sinanuyan/pi_clock/photo_2024-10-13_14-28-23.jpg

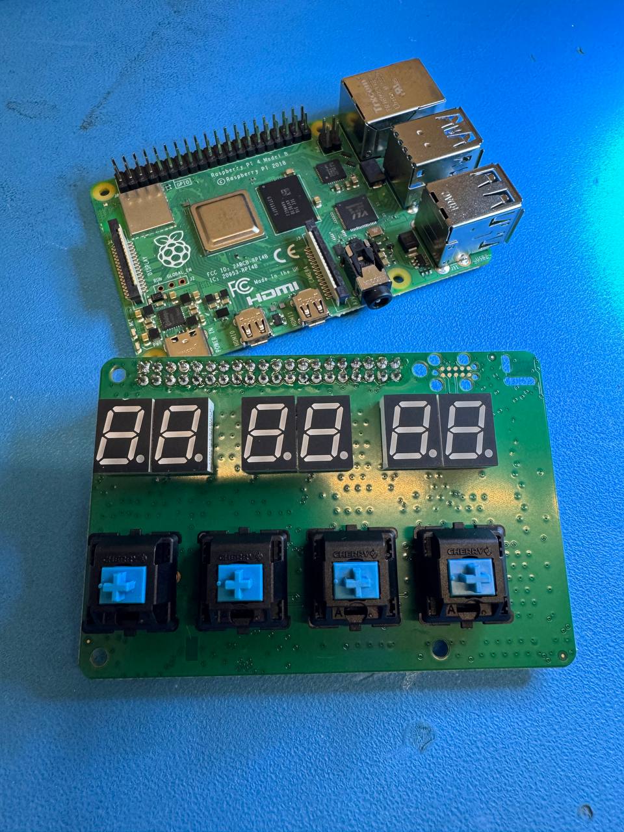
photo_2024-10-13_14-28-23.jpg
