sinanuyan/pi_clock/images/pcb/pcb_7.jpg

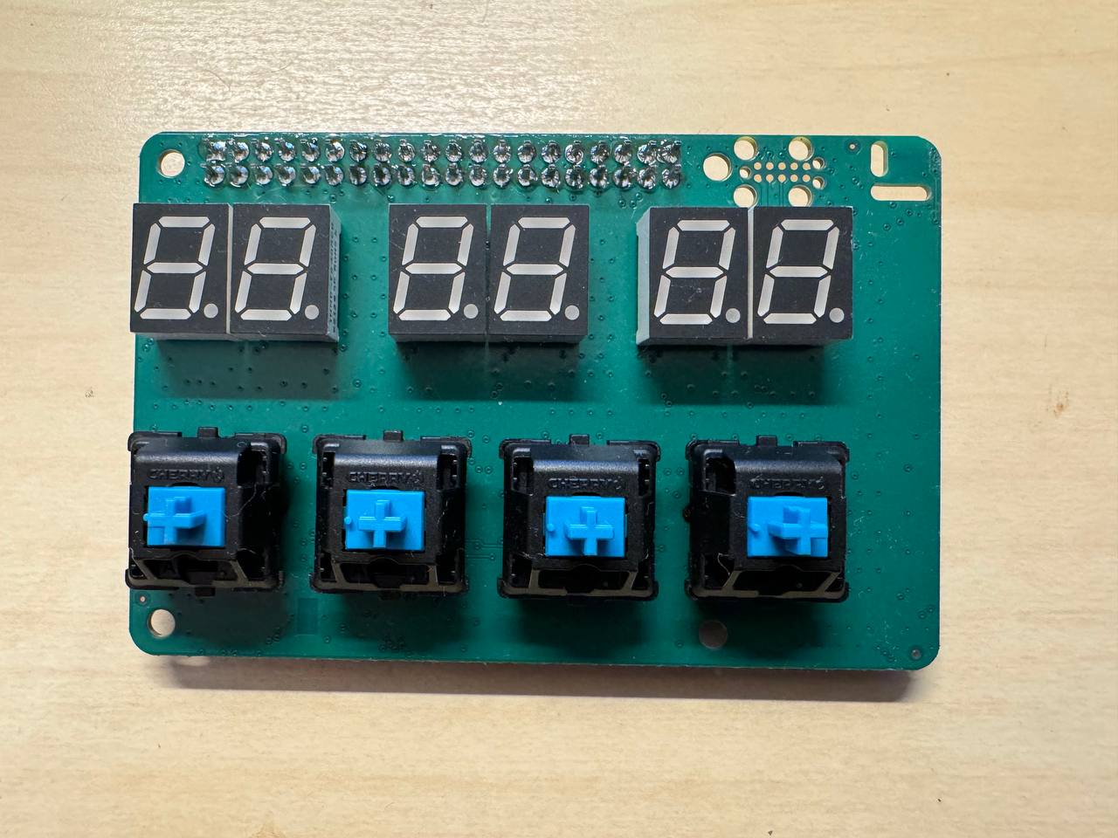
images/pcb/pcb_7.jpg
