sinanuyan/pi_clock/hardware/40_asm/README.md

This folder is for the multiboard project. Delete the multiboard project in case there is no assembly needed (e.g. wireless modules).
