sinanuyan/pi_clock/docs/back.png

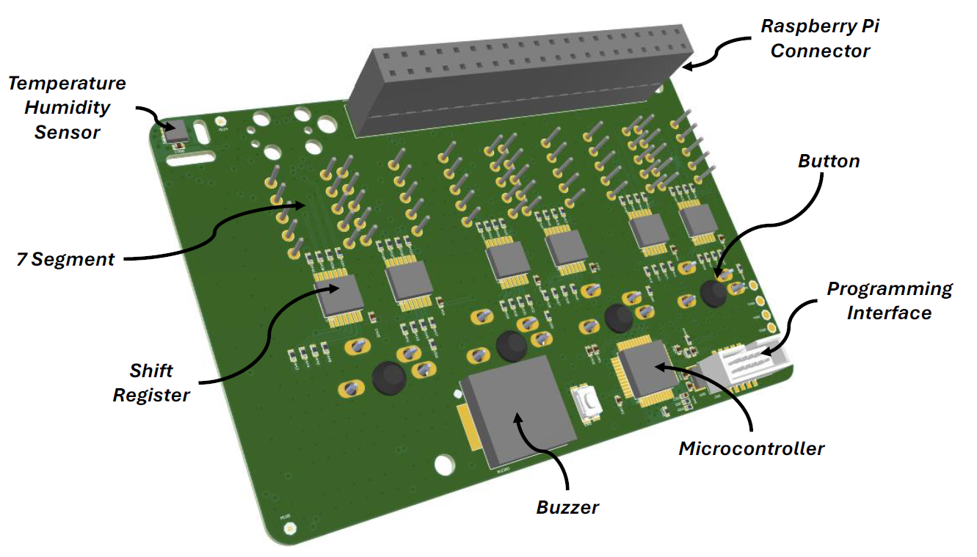
docs/back.png
