sinanuyan/pi_clock/docs/front.png

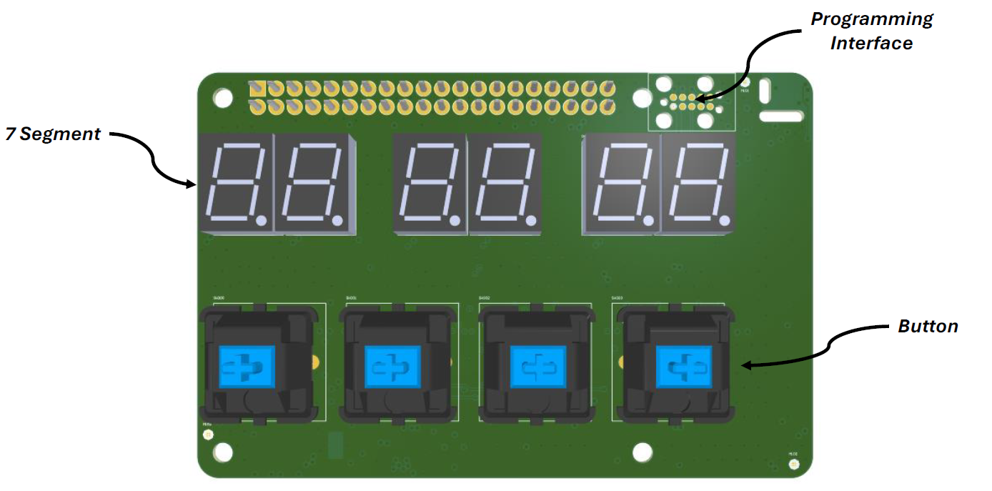
docs/front.png
