sinanuyan/pi_clock/hardware/50_doc/sch_overview.png

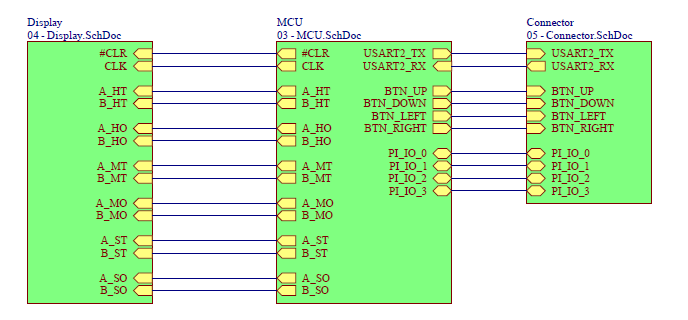
hardware/50_doc/sch_overview.png
