sinanuyan/pi_clock/images/3d_cad/pi_clock_2.png

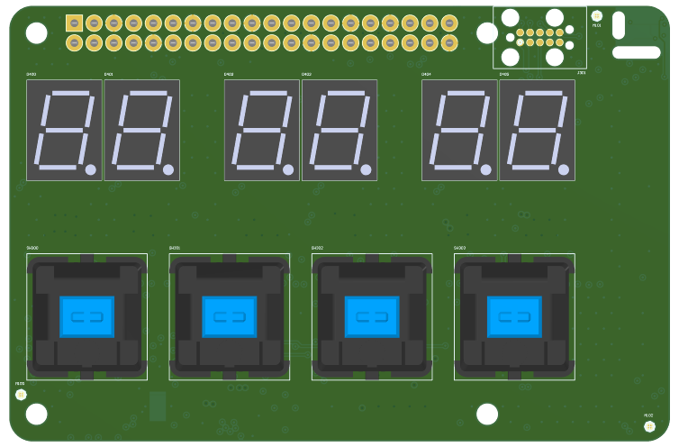
images/3d_cad/pi_clock_2.png
