sinanuyan/pi_clock/images/3d_cad/pi_clock_9.png

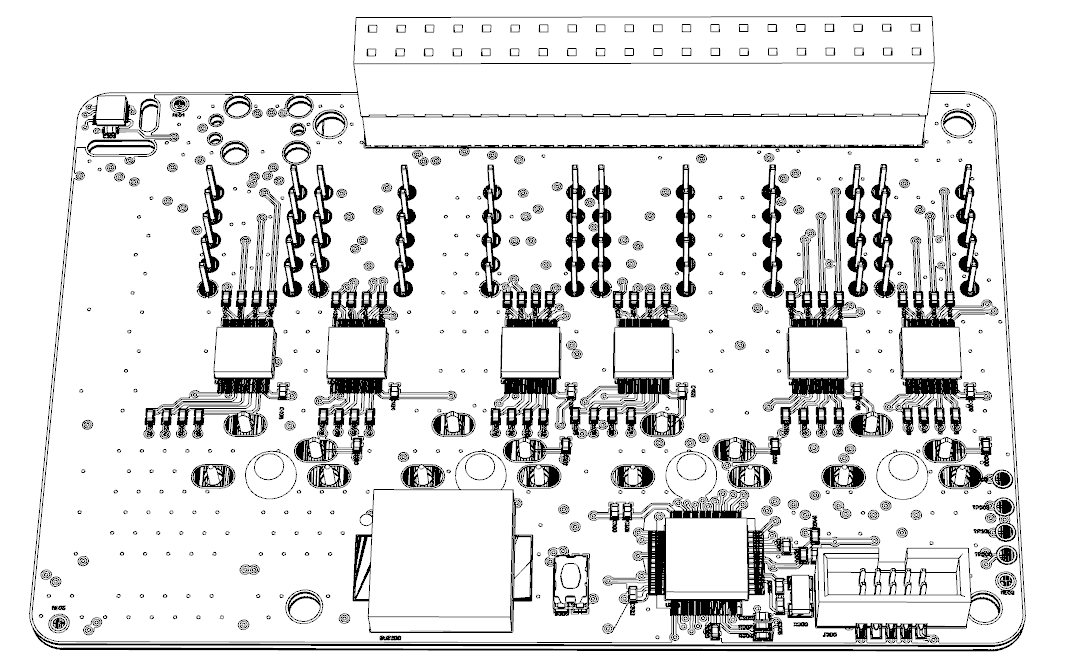
images/3d_cad/pi_clock_9.png
