sinanuyan/pi_clock/images/blockdiagram/system_overview.drawio.png

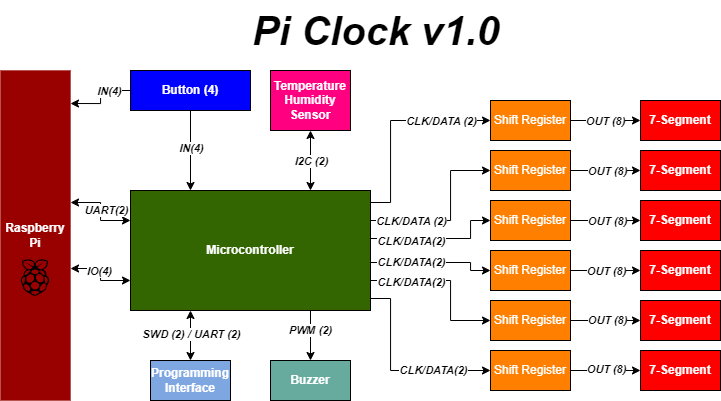
images/blockdiagram/system_overview.drawio.png
