sinanuyan/pi_clock/images/key_caps.jpg

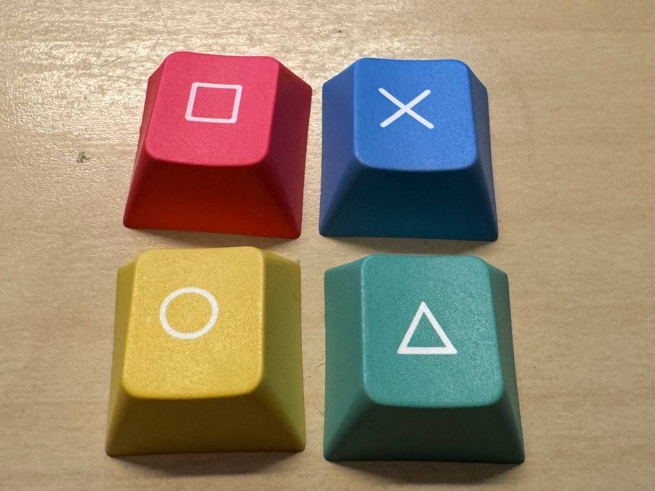
images/key_caps.jpg
