sinanuyan/pi_clock/images/pcb/pcb_1.jpg

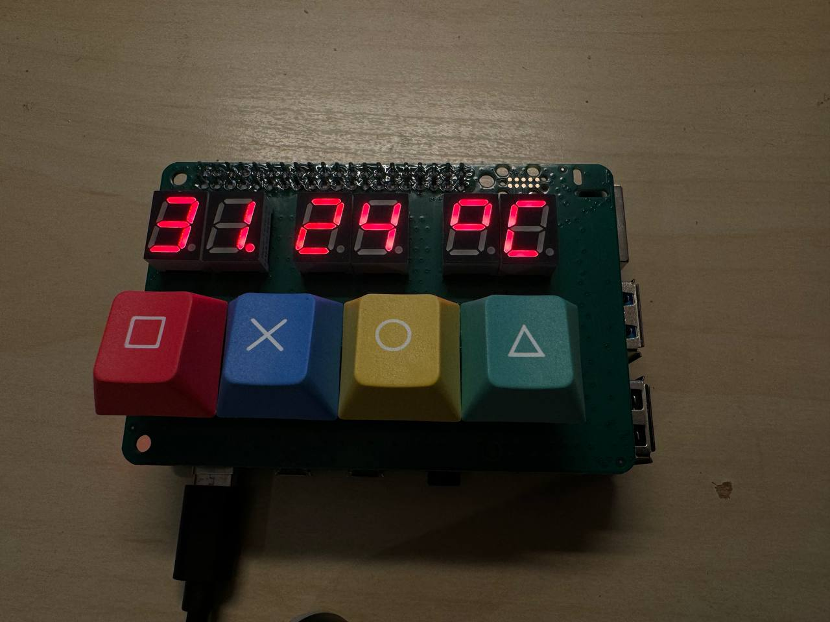
images/pcb/pcb_1.jpg
