sinanuyan/pi_clock/images/pcb/pcb_2.jpg

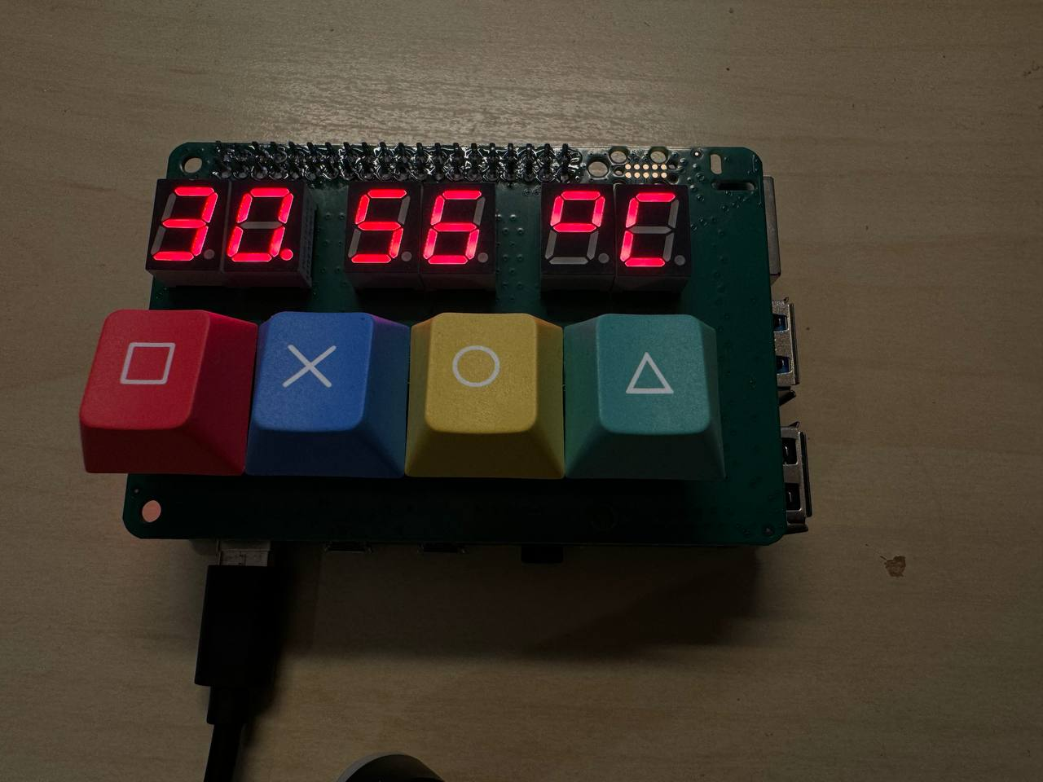
images/pcb/pcb_2.jpg
