sinanuyan/pi_clock/images/pcb/pcb_3.jpg

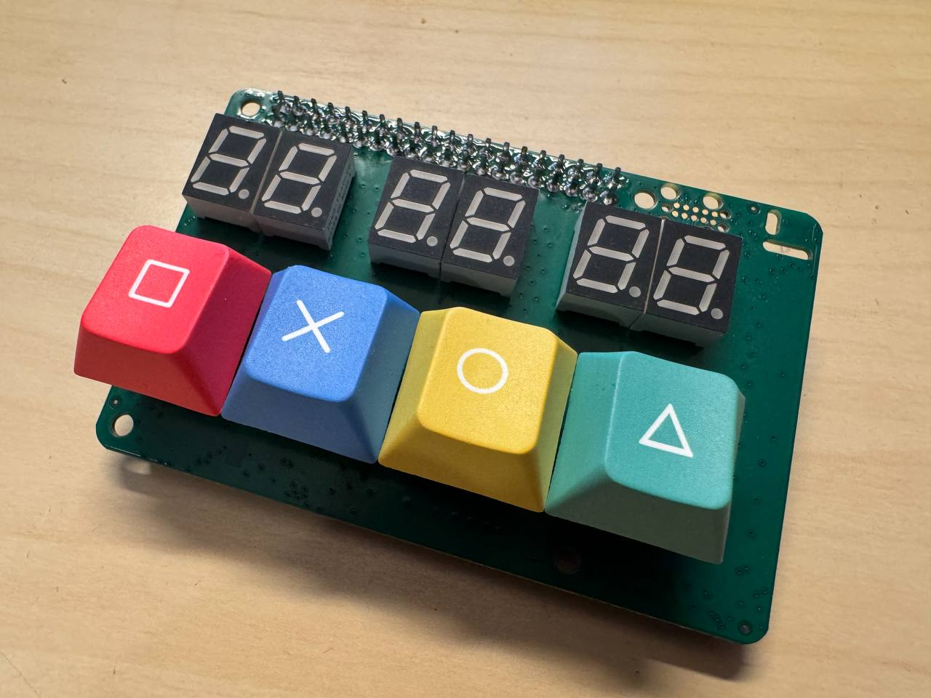
images/pcb/pcb_3.jpg
