sinanuyan/pi_clock/images/pcb/pcb_4.jpg

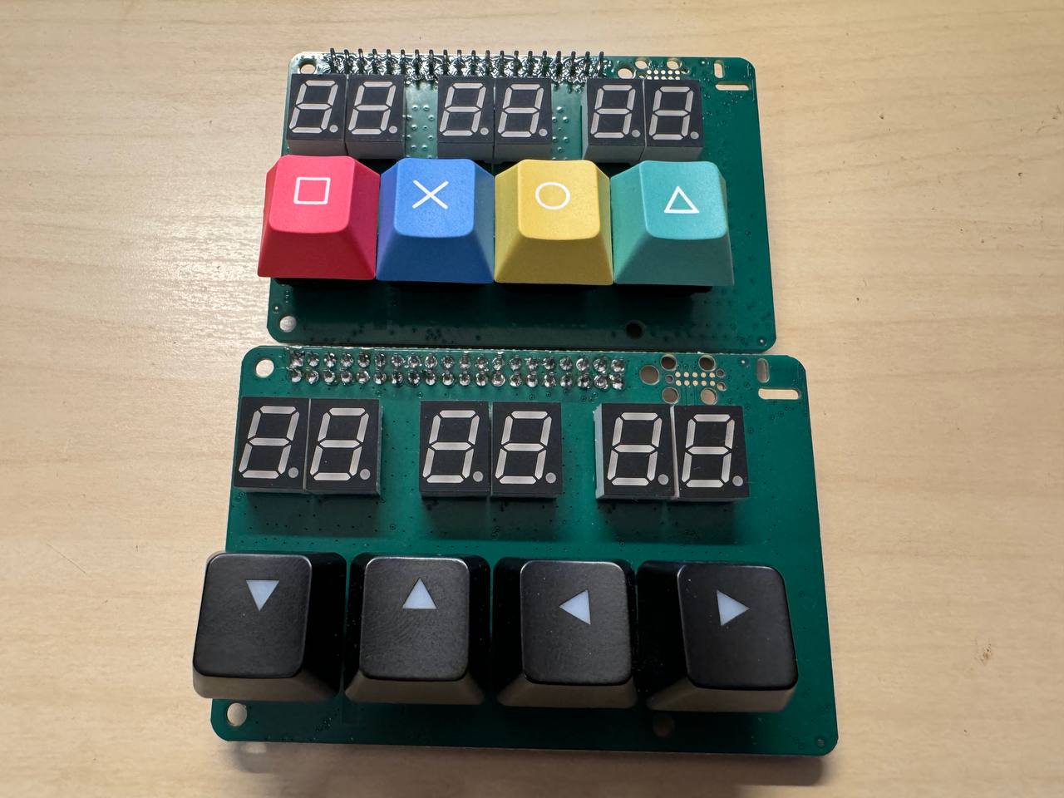
images/pcb/pcb_4.jpg
