sinanuyan/pi_clock/images/pcb/pcb_5.jpg

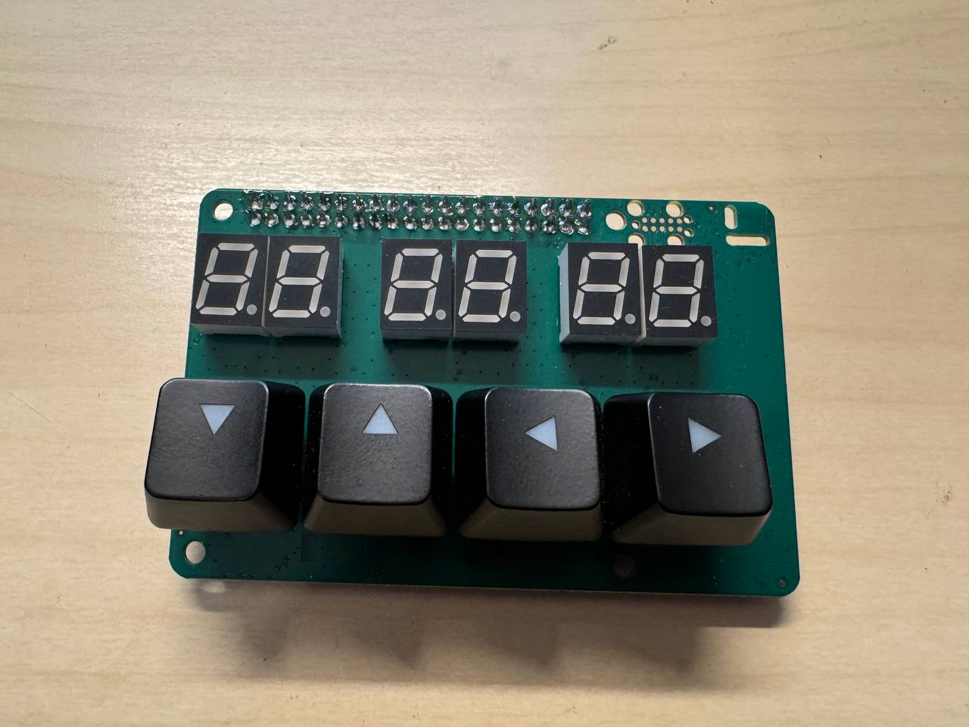
images/pcb/pcb_5.jpg
