sinanuyan/pi_clock/images/pcb/pcb_6.jpg

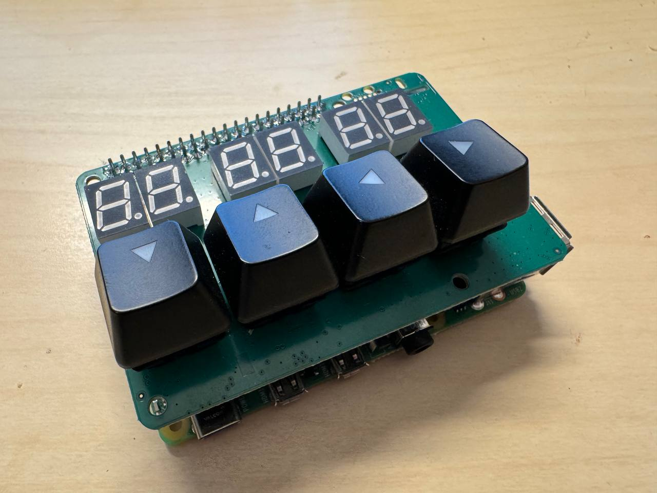
images/pcb/pcb_6.jpg
