sinanuyan/pi_clock/photo_2024-10-13_14-27-37 (2).jpg

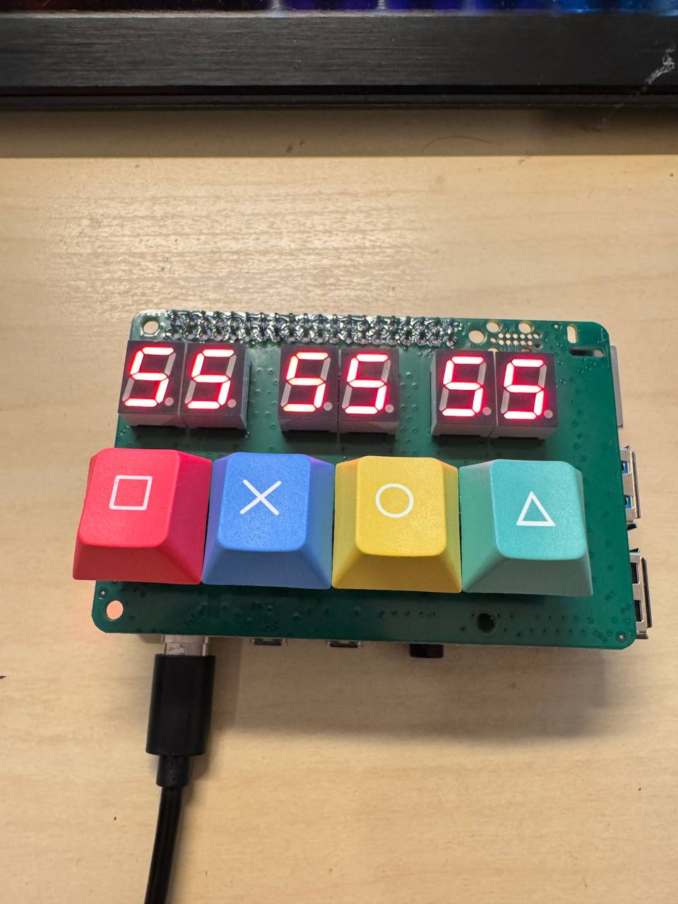
photo_2024-10-13_14-27-37 (2).jpg
