sinanuyan/pi_clock/hardware/60_projectoutput/pi-clock/pi_clock_2_B_1_SCH_BOM_PP_Data/ComponentState/pi_clock_2_B_1_ComponentState.html

Date: |  | 08.12.2024
Time: |  | 22:37:54
Elapsed Time: |  | 00:00:01
Document | Component | Result check
pi_clock.PcbDoc | D400 | Component state "New" is restricted
pi_clock.PcbDoc | D401 | Component state "New" is restricted
pi_clock.PcbDoc | D402 | Component state "New" is restricted
pi_clock.PcbDoc | D403 | Component state "New" is restricted
pi_clock.PcbDoc | D404 | Component state "New" is restricted
pi_clock.PcbDoc | D405 | Component state "New" is restricted
pi_clock.PcbDoc | J500 | Component state "New" is restricted
pi_clock.PcbDoc | SW300 | Component state "New" is restricted
pi_clock.PcbDoc | SW301 | Component state "New" is restricted
pi_clock.PcbDoc | SW302 | Component state "New" is restricted
pi_clock.PcbDoc | SW303 | Component state "New" is restricted
pi_clock.PcbDoc | U300 | Component state "New" is restricted
pi_clock.PcbDoc | U400 | Component state "New" is restricted
pi_clock.PcbDoc | U401 | Component state "New" is restricted
pi_clock.PcbDoc | U402 | Component state "New" is restricted
pi_clock.PcbDoc | U403 | Component state "New" is restricted
pi_clock.PcbDoc | U404 | Component state "New" is restricted
pi_clock.PcbDoc | U405 | Component state "New" is restricted
03 - MCU.SchDoc | SW300 | Component state "New" is restricted
03 - MCU.SchDoc | SW301 | Component state "New" is restricted
03 - MCU.SchDoc | SW302 | Component state "New" is restricted
03 - MCU.SchDoc | SW303 | Component state "New" is restricted
03 - MCU.SchDoc | U300 | Component state "New" is restricted
04 - Display.SchDoc | D400 | Component state "New" is restricted
04 - Display.SchDoc | D401 | Component state "New" is restricted
04 - Display.SchDoc | D402 | Component state "New" is restricted
04 - Display.SchDoc | D403 | Component state "New" is restricted
04 - Display.SchDoc | D404 | Component state "New" is restricted
04 - Display.SchDoc | D405 | Component state "New" is restricted
04 - Display.SchDoc | U400 | Component state "New" is restricted
04 - Display.SchDoc | U401 | Component state "New" is restricted
04 - Display.SchDoc | U402 | Component state "New" is restricted
04 - Display.SchDoc | U403 | Component state "New" is restricted
04 - Display.SchDoc | U404 | Component state "New" is restricted
04 - Display.SchDoc | U405 | Component state "New" is restricted
05 - Connector.SchDoc | J500 | Component state "New" is restricted
