sinanuyan/pi_clock/hardware/60_projectoutput/pi-clock/pi_clock_2_B_1_SCH_BOM_PP_Data/BOM/pi_clock_2_B_1_BOM.xlsx

Designator | Quantity | Comment | Description | Footprint | Properties | Supplier 1 | Supplier Part Number 1 | Manufacturer | Manufacturer Part Number | Replaceable (YES/NO/with)
BUZ300 | 1 | AST1240MLTRQ | Buzzers Transducer, Externally Driven Piezo 3V 5mA 4kHz 75dB @ 3V, 10cm Surface Mount Solder Pads | AST1240MLTRQ |  | DigiKey | 458-1094-1-ND | Mallory Sonalert Products Inc. | AST1240MLTRQ
C300 | 1 | CL05A106MP8NUB8 | 10µF ±20% 10V Ceramic Capacitor X5R 0402 (1005 Metric) | CAPC0402(1005)60_L |  | Digi-Key | 1276-6830-1-ND | Samsung Electro-Mechanics | CL05A106MP8NUB8
C301, C302, C303, C304, C307, C308, C400, C401, C402, C403, C404, C405 | 12 | GRM155R62A104KE14D | 0.1µF ±10% 100V Ceramic Capacitor X5R 0402 (1005 Metric) | CAPC0402(1005)60_L |  | Digi-Key | 490-10458-1-ND | Murata Electronics | GRM155R62A104KE14D
C305, C306 | 2 | CC0402BRNPO9BN9R0 | 9pF ±0.1pF 50V Ceramic Capacitor C0G, NP0 0402 (1005 Metric) | CAPC0402(1005)60_L |  | Digi-Key | 311-1629-1-ND | Yageo | CC0402BRNPO9BN9R0
D400, D401, D402, D403, D404, D405 | 6 | INND-TS40RCB | Display Modules - LED Character and Numeric Red 7-Segment 1 Character Common Cathode 2V 20mA 0.508" H x 0.379" W x 0.250" D (12.90mm x 9.63mm x 6.36mm) 10-DIP (0.300", 7.62mm) | INND-TS40RCB-Footprint-1 |  | Digi-Key | 1830-1155-ND | Inolux | INND-TS40RCB
J300 | 1 | 3220-10-0300-00 | Connector Header Surface Mount 10 position 0.050" (1.27mm) | 3220-10-0300-00-Footprint-1 |  | Digi-Key | 1175-1629-ND | CNC Tech | 3220-10-0300-00
J500 | 1 | ESW-120-23-T-D | 40 Position Elevated Socket Connector 0.100" (2.54mm) Through Hole Tin | ESW-120-23-T-D-Footprint-1 |  | Digi-Key | 2031-ESW-120-23-T-D-ND | Samtec Inc. | ESW-120-23-T-D
Q400, Q401, Q402, Q403, Q404, Q405 | 6 | BSS138L | MOSFET N-CH 50V 200MA SOT-23 | SOT23-3 |  | Digikey | BSS138LCT-ND | ON Semiconductor | BSS138L
R300, R301, R302, R303, R304, R305, R306, R307, R400, R449, R450, R451, R452, R453, R454 | 15 | RMCF0402FT4K70 | 4.7 kOhms ±1% 0.063W, 1/16W Chip Resistor 0402 (1005 Metric) Automotive AEC-Q200 Thick Film | RESC0402(1005)_L |  | Digi-Key | RMCF0402FT4K70CT-ND | Stackpole Electronics Inc | RMCF0402FT4K70
R401, R402, R403, R404, R405, R406, R407, R408, R409, R410, R411, R412, R413, R414, R415, R416, R417, R418, R419, R420, R421, R422, R423, R424, R425, R426, R427, R428, R429, R430, R431, R432, R433, R434, R435, R436, R437, R438, R439, R440, R441, R442, R443, R444, R445, R446, R447, R448 | 48 | RMCF0402FT470R | 470 Ohms ±1% 0.063W, 1/16W Chip Resistor 0402 (1005 Metric) Automotive AEC-Q200 Thick Film | RESC0402(1005)_L |  | Digi-Key | 738-RMCF0402FT470RCT-ND | Stackpole Electronics Inc | RMCF0402FT470R
S300 | 1 | KMR211GLFS | SWITCH TACTILE SPST-NO 0.05A 32V | KMR211GLFS |  | Digi-Key | 401-1426-1-ND | C&K Components | KMR211GLFS
SW300, SW301, SW302, SW303 | 4 | MX1A-E1NW | Pushbutton Switch SPST-NO Keyswitch Through Hole | MX1A-E1NW-Footprint-1 |  | Digi-Key | CH197-ND | Cherry Americas LLC | MX1A-E1NW
U300 | 1 | STM32L010C6T6 | RISC Microcontroller, 32-Bit, FLASH, CORTEX-M0 CPU, 32MHz | LQFP-48 (LQ) |  | Digi-Key | 497-19662-ND | STMicroelectronics | STM32L010C6T6
U301 | 1 | SHT31-DIS-B | SENSIRION SHT31-DIS-B Humidity Sensor, 2 %, 3.3 V, 0% to 100% Relative Humidity, TDFN, 8 Pins, 8 s | 8 - Pin DFN 2.5 x 2.5 mm x 0.9 mm |  | Digi-Key | 1649-1011-1-ND | Sensirion | SHT31-DIS-B
U400, U401, U402, U403, U404, U405 | 6 | SN74HCS264PWR | Shift Shift Register 1 Element 8 Bit 14-TSSOP | TSSOP-14 |  | Digi-Key | 296-SN74HCS264PWRCT-ND | Texas Instruments | SN74HCS264PWR
X300 | 1 | ABS07-32.768KHZ-6-T | 32.768kHz ±20ppm Crystal 6pF 70 kOhms 2-SMD, No Lead | ABRA-ABS07_V |  | Digi-Key | 535-11898-1-ND | Abracon LLC | ABS07-32.768KHZ-6-T
