sinanuyan/pi_clock/hardware/enclosure_top-Extrude.stl

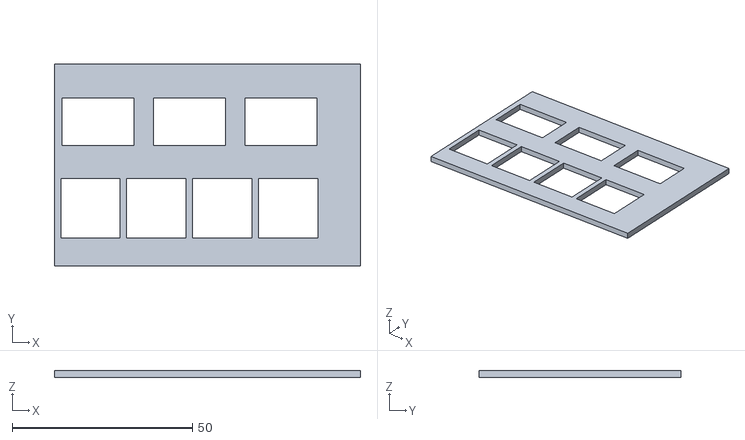
[picture p29: CAD file, 2025-01-09]
hardware/enclosure_top-Extrude.stl
85.0 x 56.0 x 2.00
