sinanuyan/pi_clock/hardware/enclosure_top.FCStd

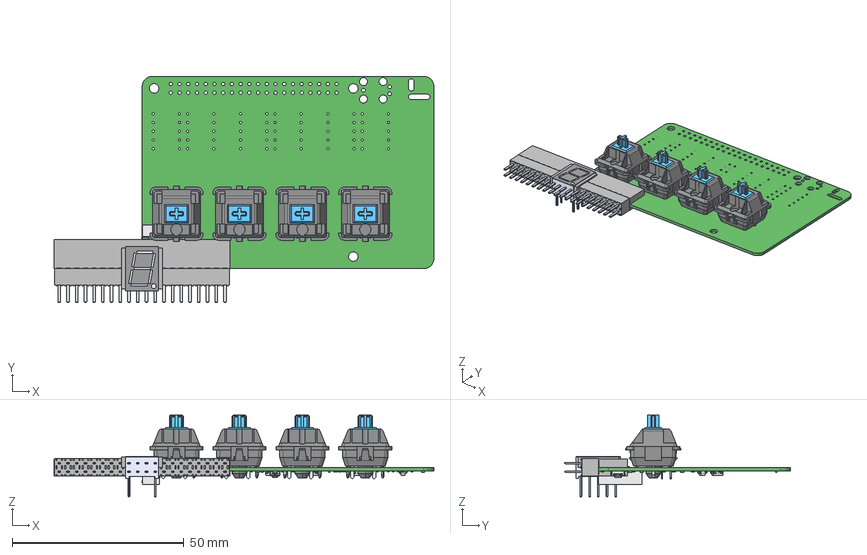
[picture p30: CAD file, 2025-01-09]
hardware/enclosure_top.FCStd
110.7 x 65.9 x 23.8 mm
R0402
R0403
R0404
R0405
R0406
R0407
R0408
R0409
R0410
R0411
R0412
R0413
R0414
R0415
R0416
R0417
R0418
R0419
R0420
R0421
R0422
R0423
R0424
R0425
User Library-SOT23-3
User Library-SOT23-004
User Library-SOT23-005
User Library-SOT23-006
User Library-SOT23-007
User Library-SOT23-008
Extruded
R0426
R0427
R0428
R0429
R0430
R0431
R0432
R0433
User Library-cap_0402
Extruded001
ESW-120-23-T-D_socket
ESW-120-23-T-D_pins
ESW-120-23-T-D2_PINS
ESW-120-23-T-D_bsocket
Extruded002
Extruded003
Extruded004
Extruded005
Extruded006
Extruded007
Extruded008
Extruded009
MX1A-E1NW
MX1A-E1NW001
MX1A-E1NW002
MX1A-E1NW003
MX1A-E1NW004
MX1A-E1NW005
MX1A-E1NW006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
