sinanuyan/pi_clock/hardware/60_projectoutput/pi-clock/pi_clock_2_B_1_PCB_Data/pi_clock_x_B_1_Technical_Data.pdf

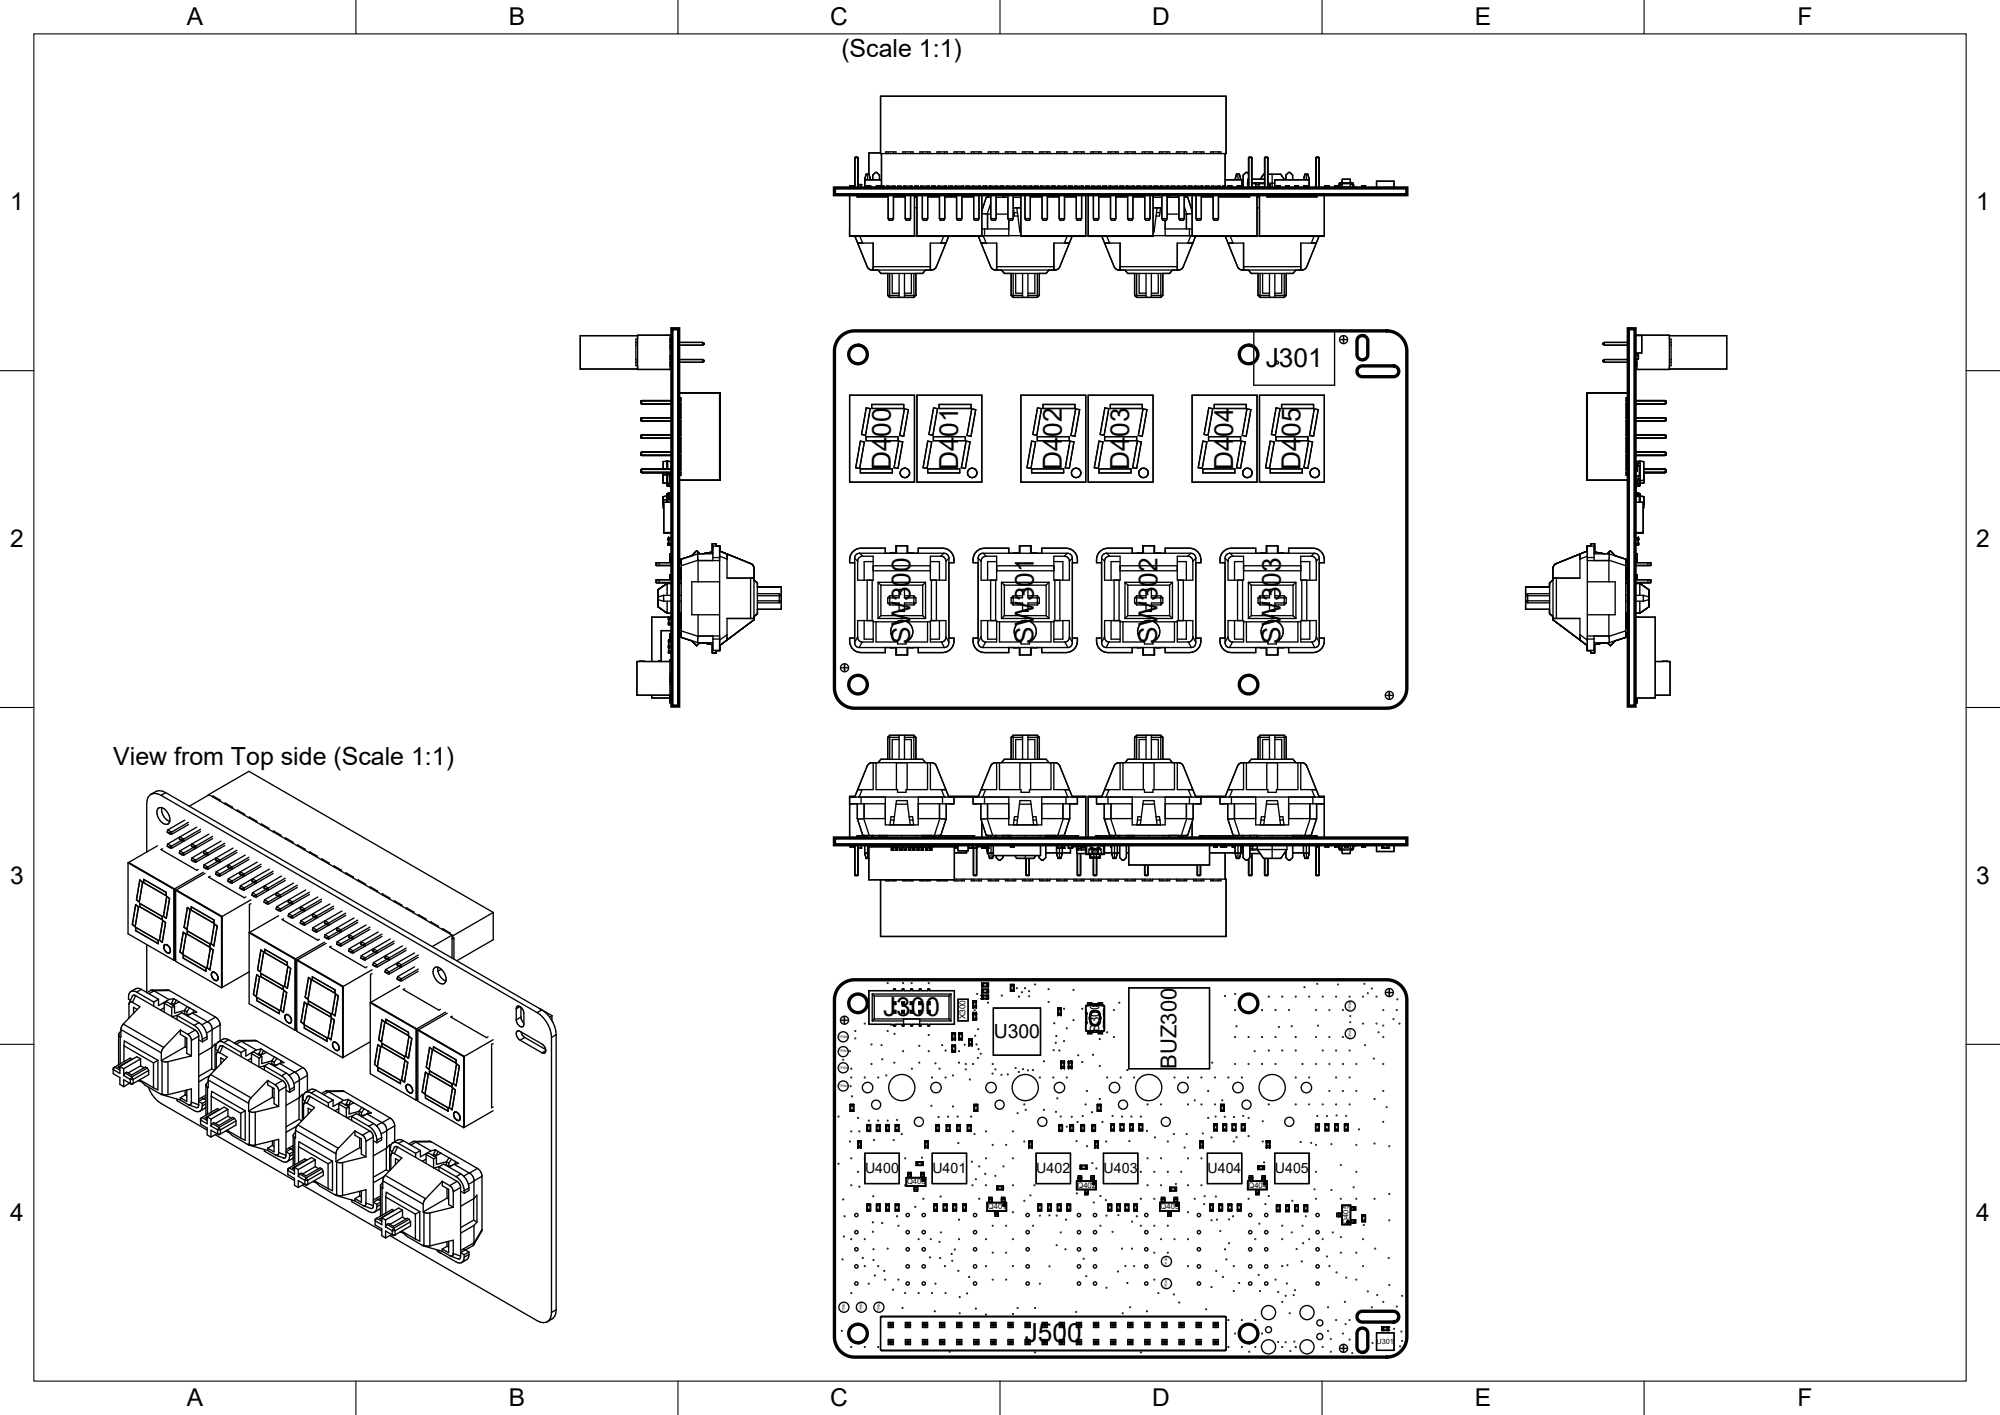
[picture p31: page 1]

View from Top side (Scale 1:1)

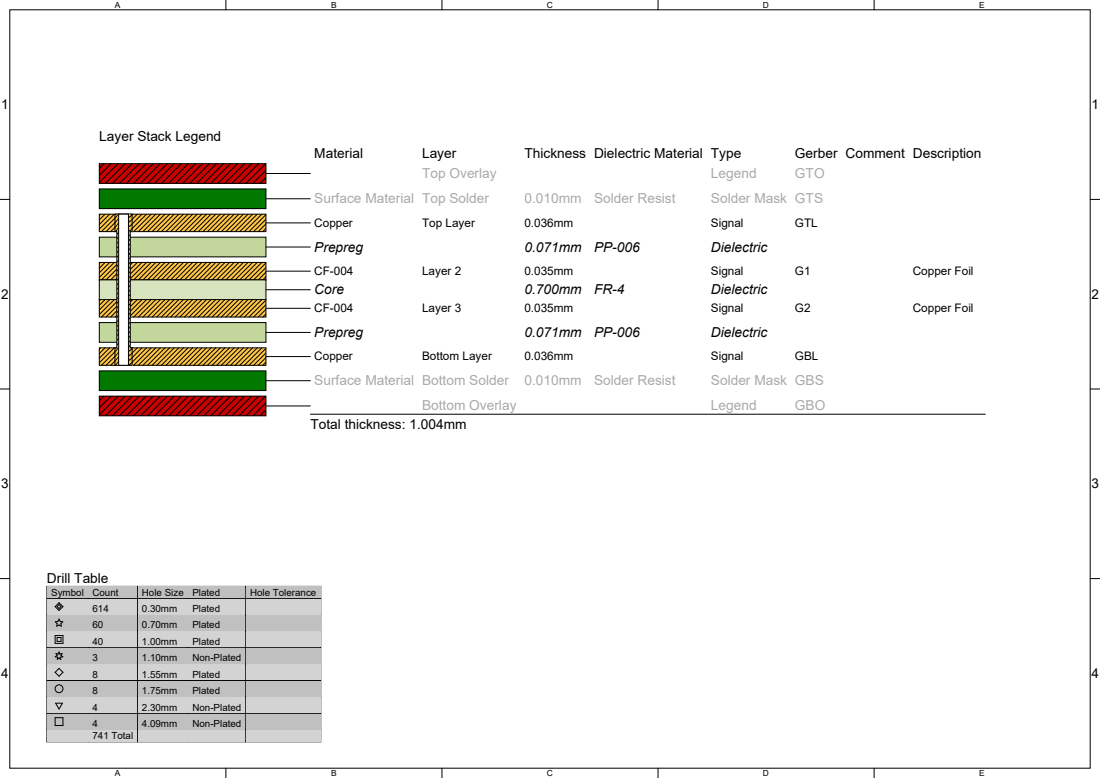
[picture p32: page 2]

Symbol | Count | Hole Size | Plated | Hole Tolerance

614 | 0.30mm | Plated
60 | 0.70mm | Plated
40 | 1.00mm | Plated
3 | 1.10mm | Non-Plated
8 | 1.55mm | Plated
8 | 1.75mm | Plated
4 | 2.30mm | Non-Plated
4 | 4.09mm | Non-Plated
741 Total

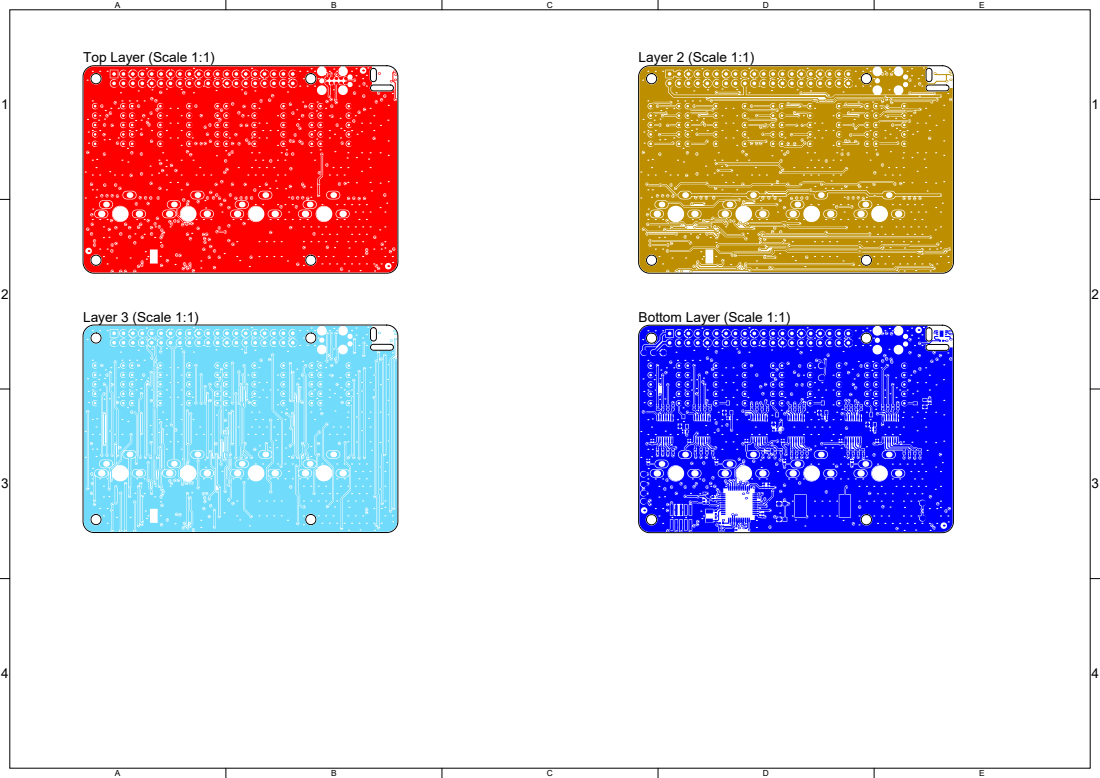
[picture p33: page 3]

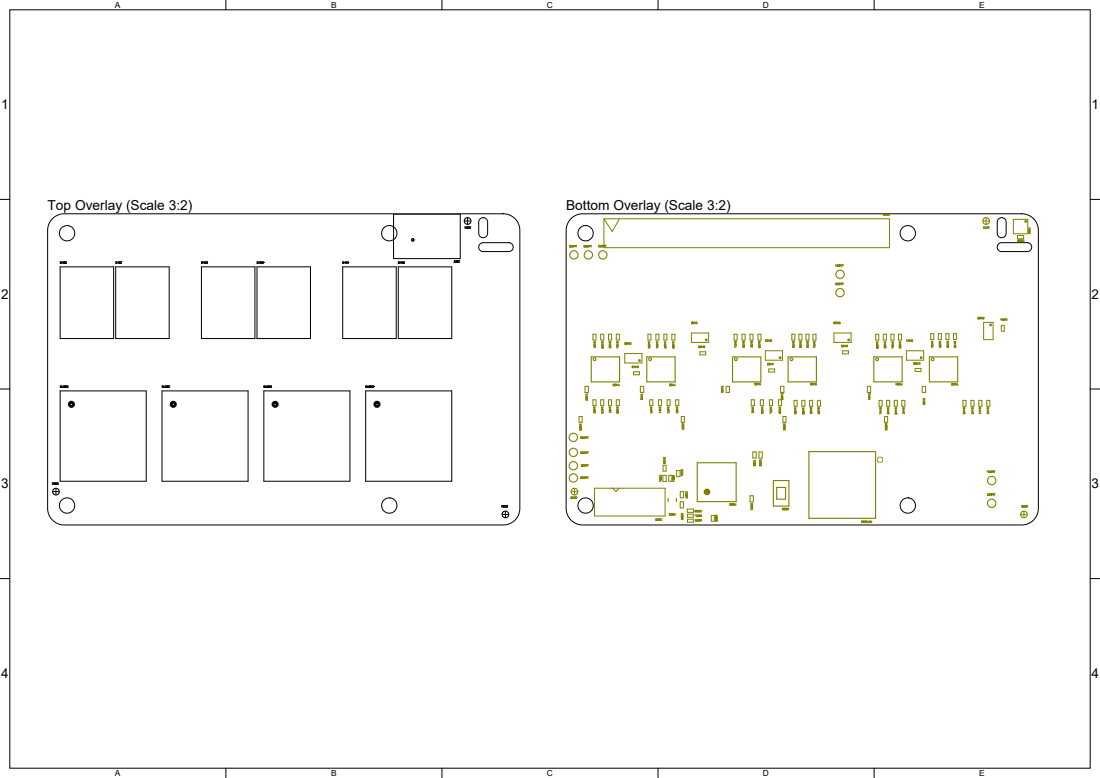
[picture p34: page 4]

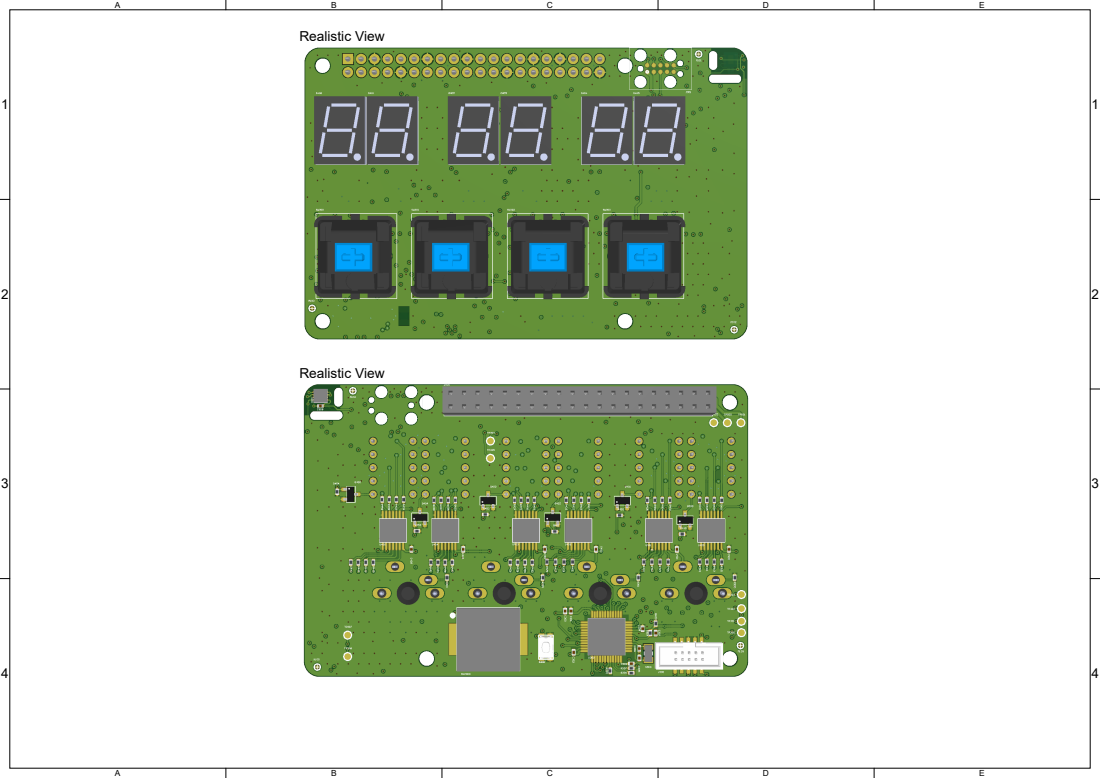
[picture p35: page 5]

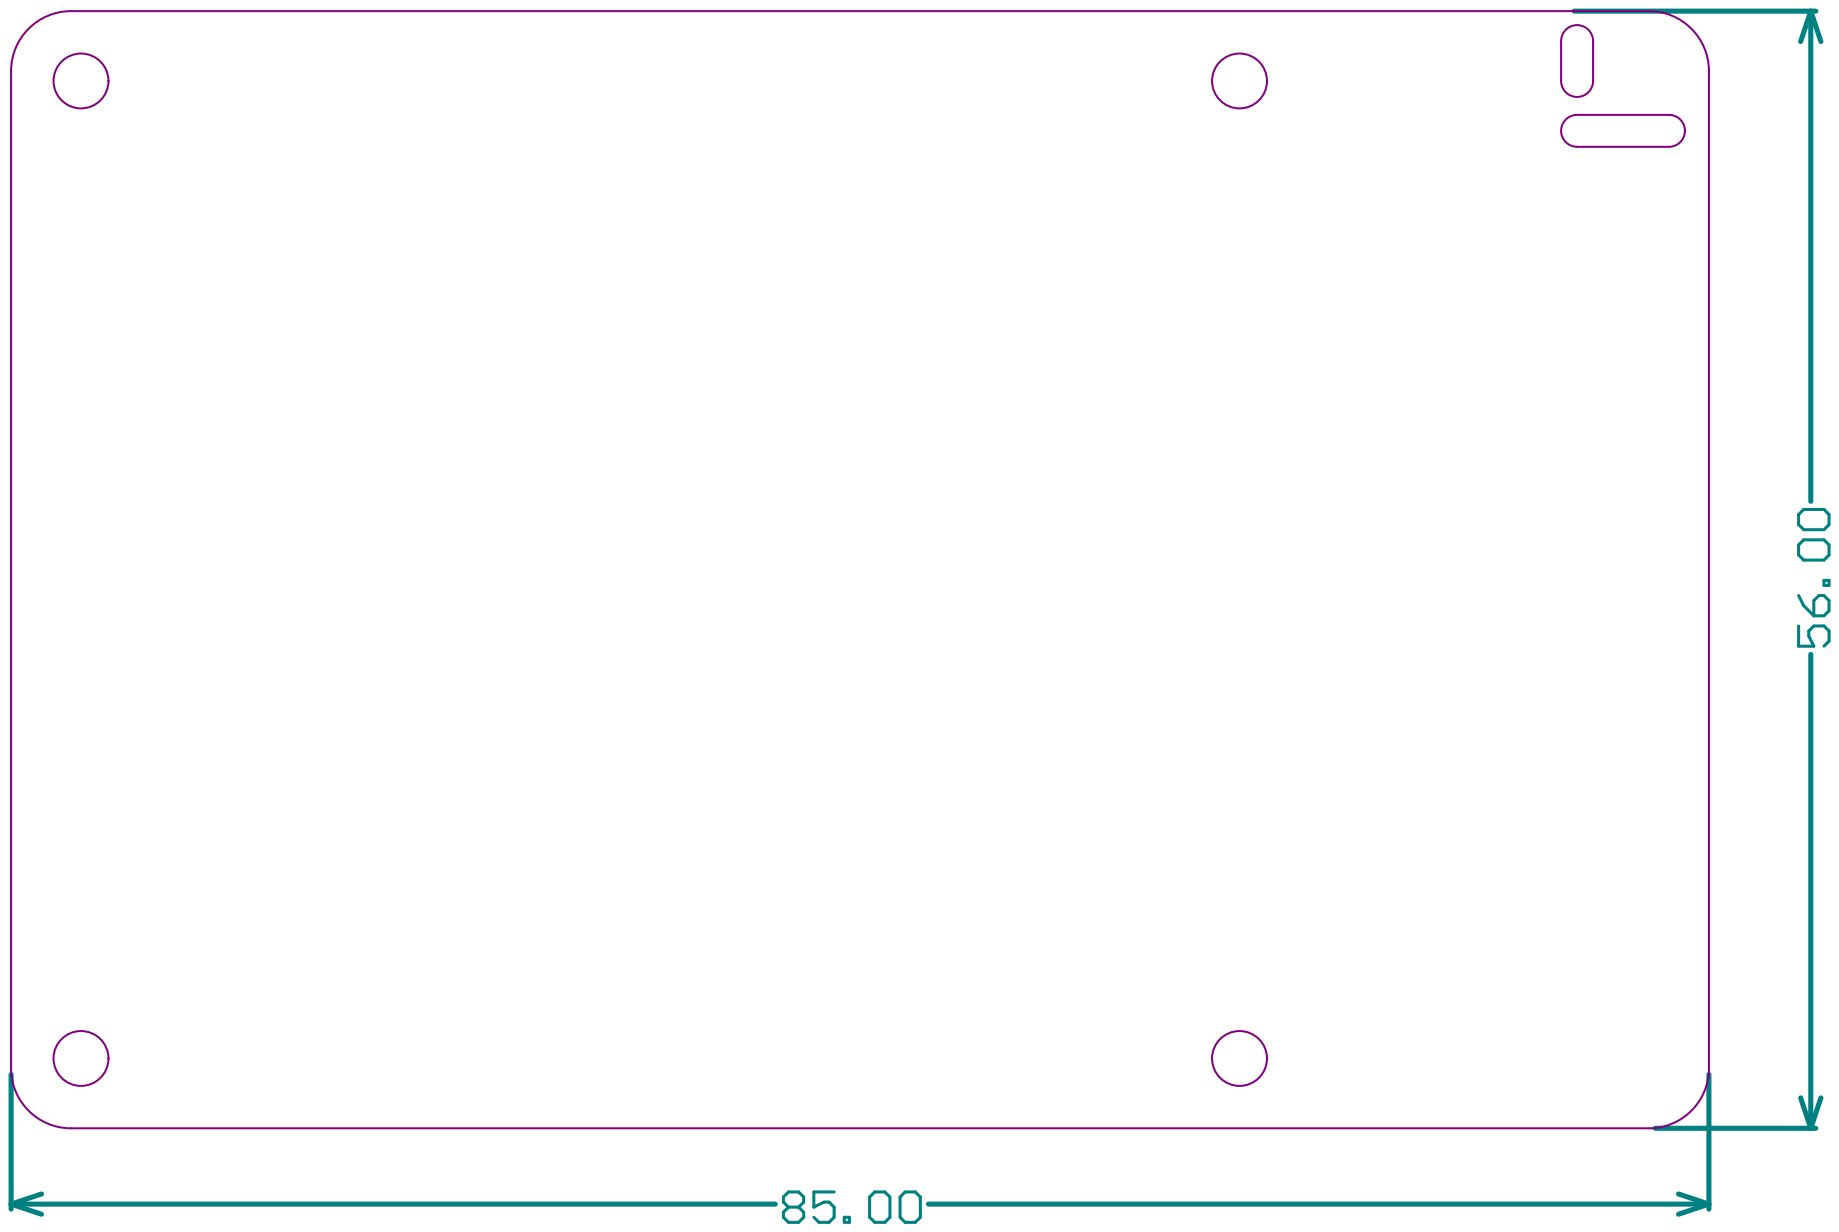
[picture p36: page 6]

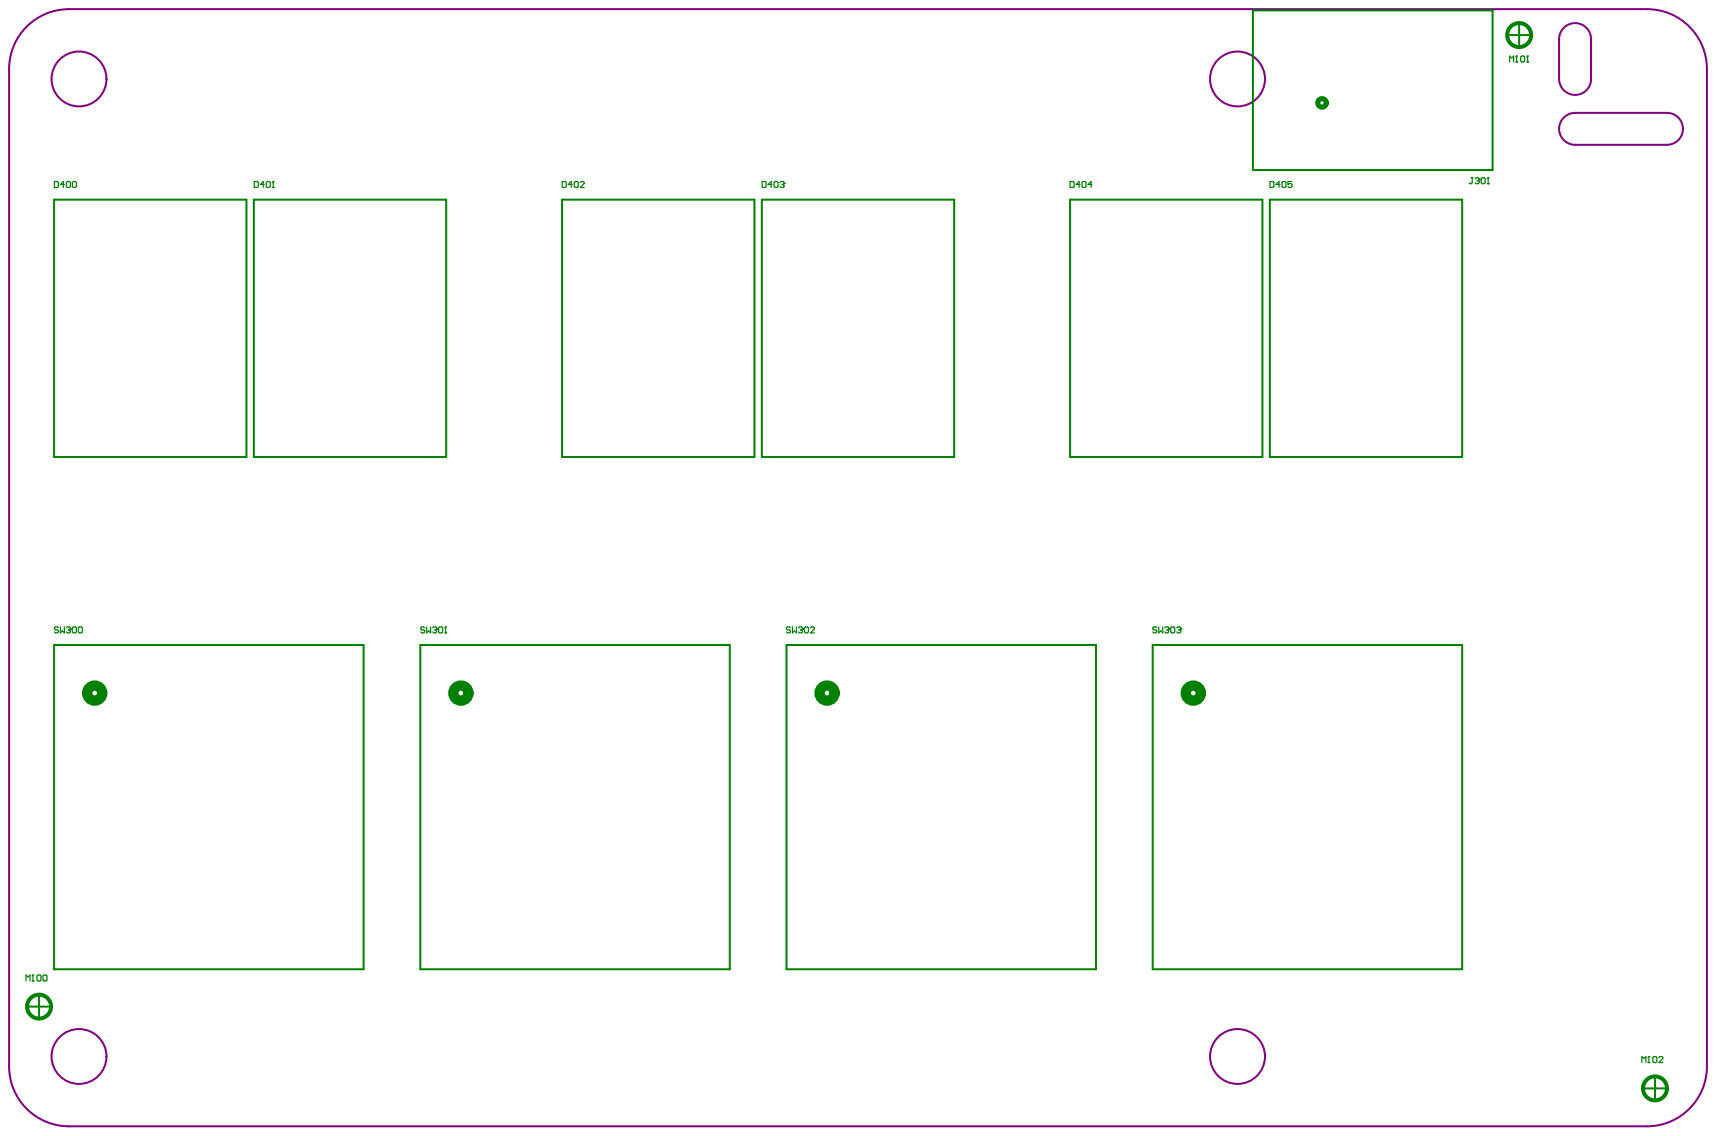
[picture p37: page 7]

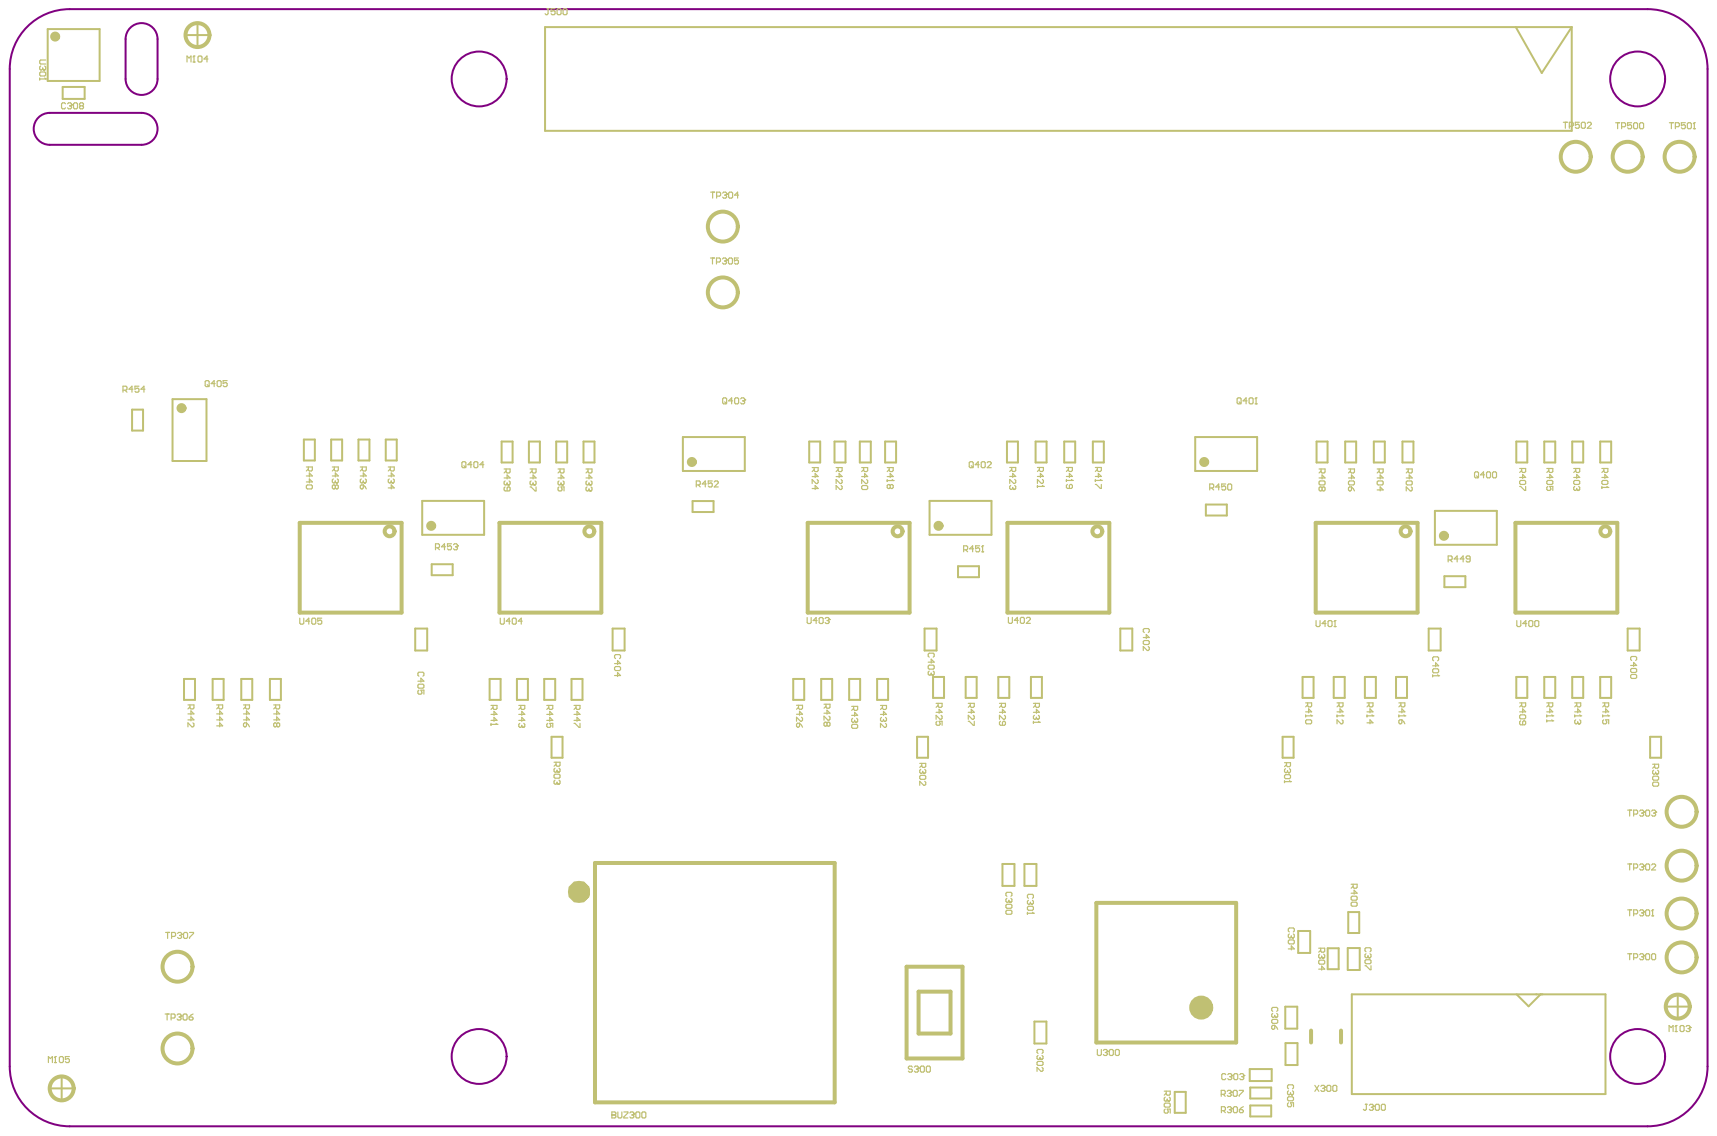
[picture p38: page 8]
