sinanuyan/pi_clock/hardware/60_projectoutput/pi-clock/pi_clock_2_B_1_SCH_BOM_PP_Data/pi_clock_2_B_1_Schematic.pdf

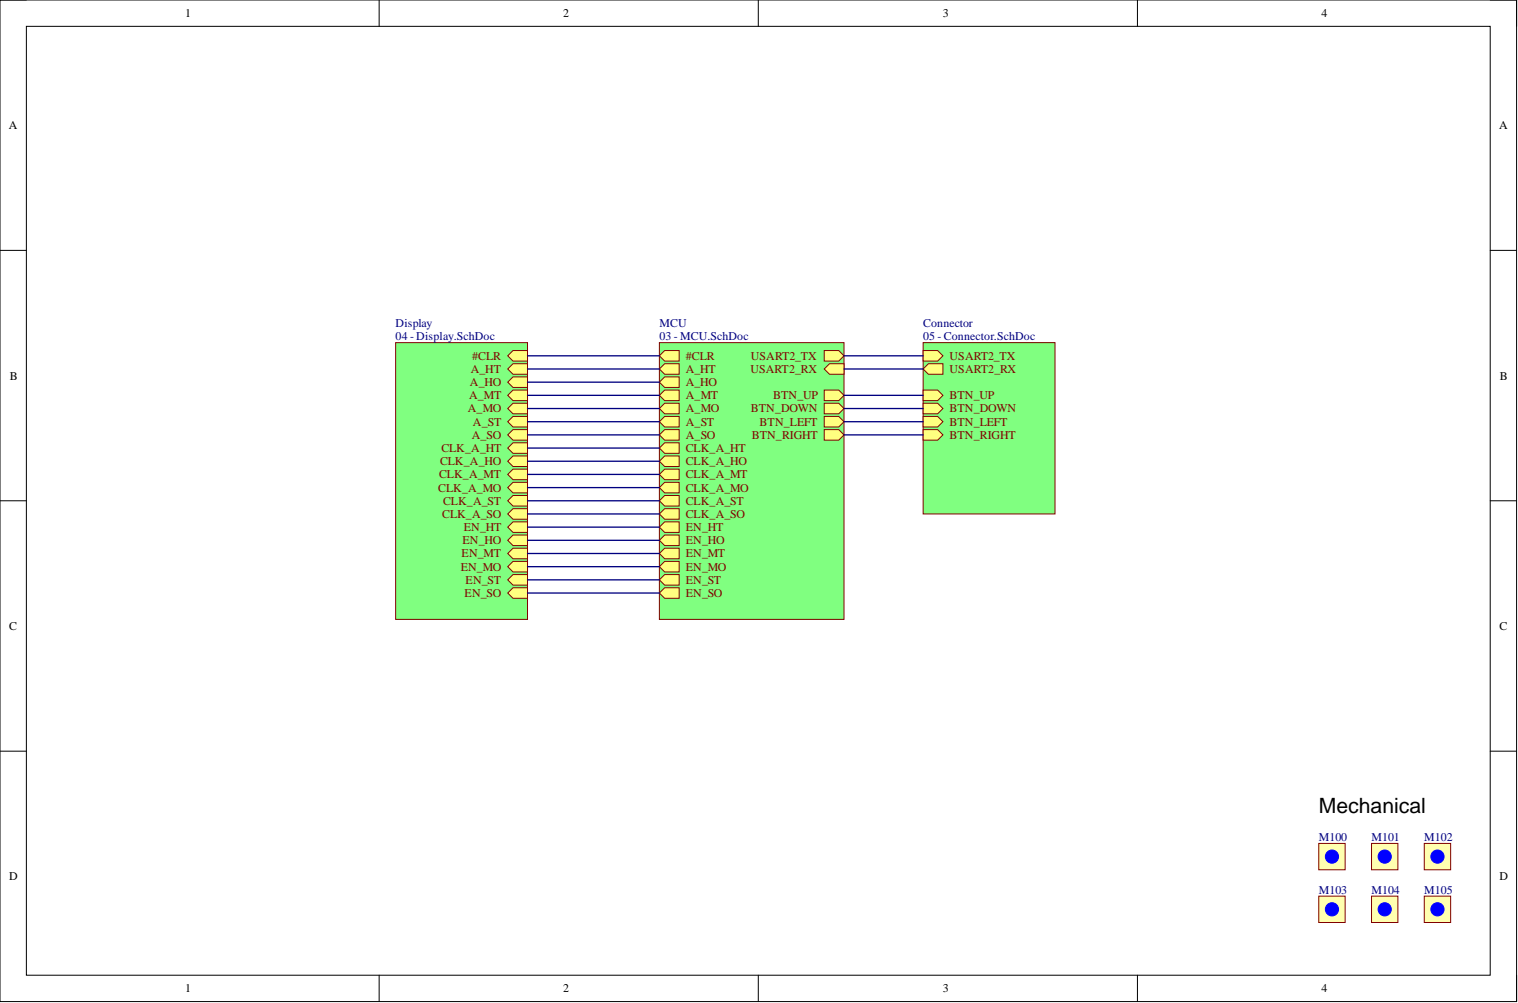
[picture p39: page 1]

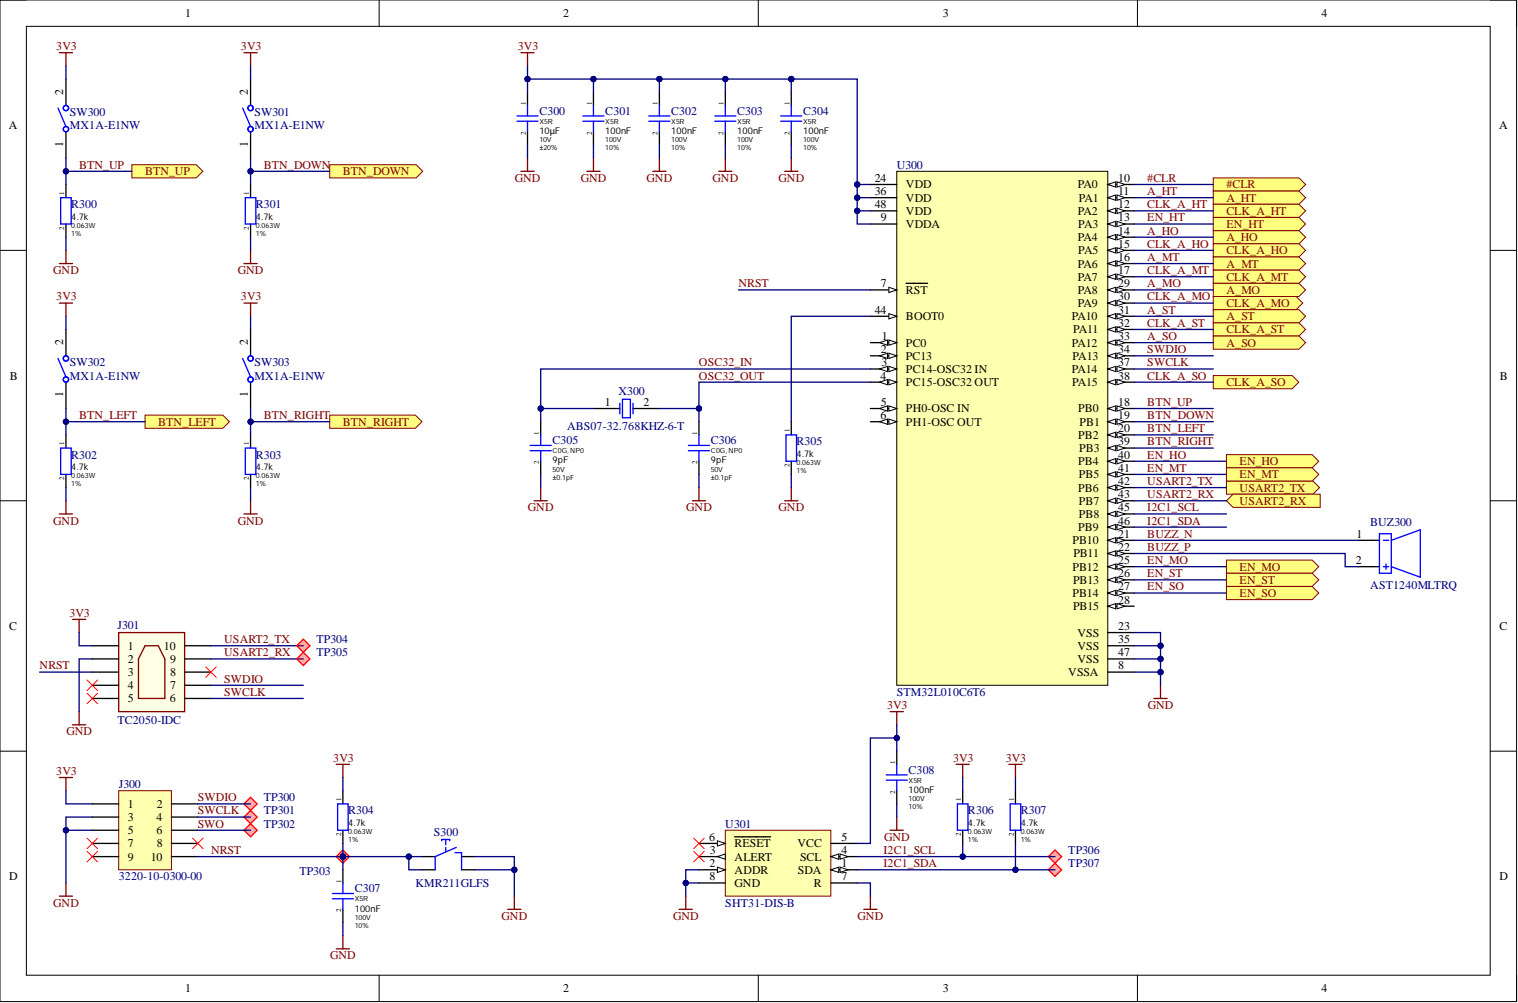
[picture p40: page 2]

OSC32_OUT | PC15-OSC32 OUT 4

PH0-OSC IN 5

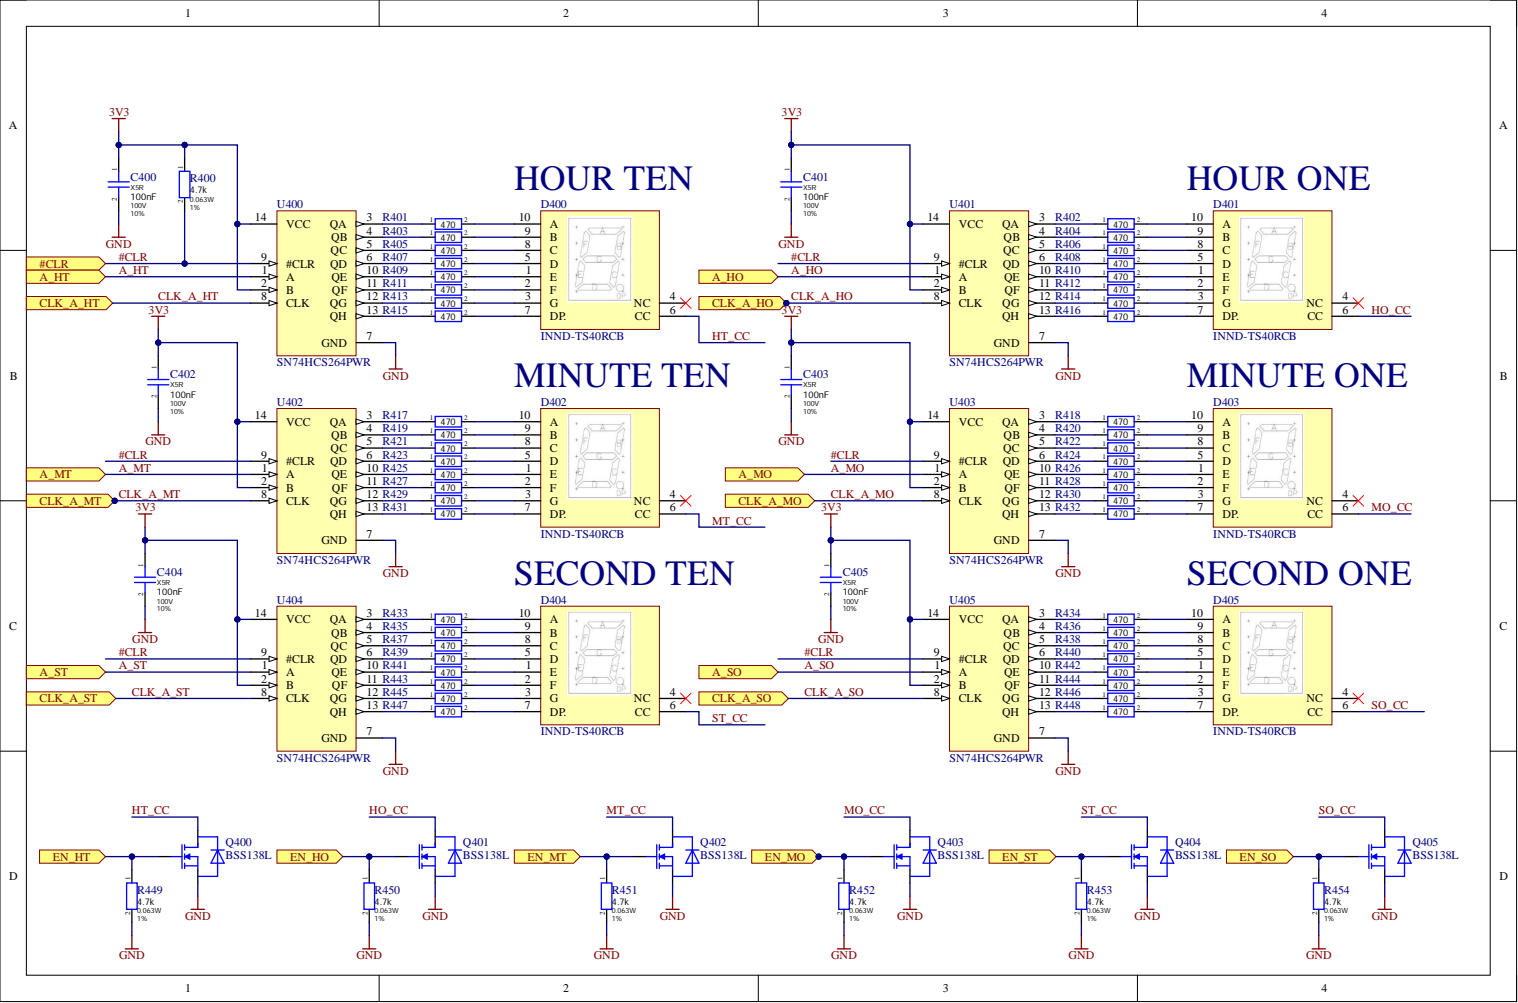
[picture p41: page 3]

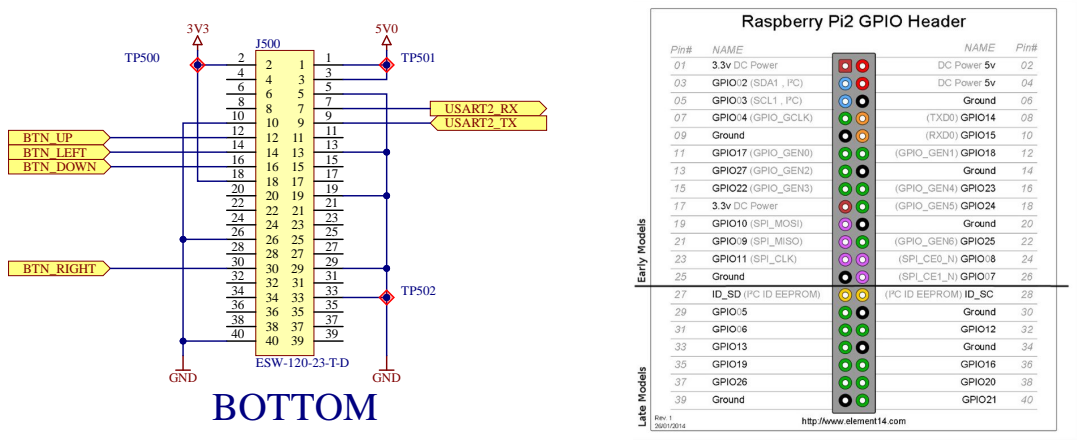
[picture p42: page 4]
