sinanuyan/pi_clock/(list of files, drawings)

Other design files:
hardware/10_sch/0A - Blockschema.SchDoc
hardware/10_sch/01 - Overview.SchDoc
hardware/10_sch/03 - MCU.SchDoc
hardware/10_sch/04 - Display.SchDoc
hardware/10_sch/05 - Connector.SchDoc
hardware/10_sch/98 - MECH.SchDoc
hardware/pi_clock.PrjPcb
