sinanuyan/pi_clock/firmware/Core/Src/main.c

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
/* Includes ------------------------------------------------------------------*/
#include "main.h"

/* USER CODE BEGIN Includes */

#include "7_segment.h"
#include "critical_section.h"
#include "button.h"
#include "pi_serial.h"

/* USER CODE END Includes */

I2C_HandleTypeDef hi2c1;

RTC_HandleTypeDef hrtc;

TIM_HandleTypeDef htim2;
TIM_HandleTypeDef htim21;

UART_HandleTypeDef huart2;

void SystemClock_Config(void);
static void MX_GPIO_Init(void);
static void MX_I2C1_Init(void);
static void MX_RTC_Init(void);
static void MX_TIM2_Init(void);
static void MX_USART2_UART_Init(void);
static void MX_TIM21_Init(void);
/* USER CODE BEGIN 0 */
uint8_t ext_btn_up_value;
uint8_t ext_btn_down_value;
uint8_t ext_btn_left_value;
uint8_t ext_btn_right_value;
uint32_t clock_value;

/* USER CODE END 0 */

/**
  * @brief  The application entry point.
  * @retval int
  */
int main(void)
{
  /* USER CODE BEGIN 1 */
	clock_value = 0;

  /* USER CODE END 1 */

  /* MCU Configuration--------------------------------------------------------*/

  /* Reset of all peripherals, Initializes the Flash interface and the Systick. */
  HAL_Init();

  /* Configure the system clock */
  SystemClock_Config();

  /* Initialize all configured peripherals */
  MX_GPIO_Init();
  MX_I2C1_Init();
  MX_RTC_Init();
  MX_TIM2_Init();
  MX_USART2_UART_Init();
  MX_TIM21_Init();
  /* USER CODE BEGIN 2 */

  	  char rx_buffer[64];
  	  char tx_buffer[16];
  	  char time_buffer[32];
  	  char date_buffer[32];

	HAL_GPIO_WritePin(EN_HO_GPIO_Port, EN_HO_Pin, 0);
	HAL_GPIO_WritePin(EN_HT_GPIO_Port, EN_HT_Pin, 0);
	HAL_GPIO_WritePin(EN_MO_GPIO_Port, EN_MO_Pin, 0);
	HAL_GPIO_WritePin(EN_MT_GPIO_Port, EN_MT_Pin, 0);
	HAL_GPIO_WritePin(EN_SO_GPIO_Port, EN_SO_Pin, 0);
	HAL_GPIO_WritePin(EN_ST_GPIO_Port, EN_ST_Pin, 0);

	HAL_GPIO_WritePin(A_HT_GPIO_Port, A_HT_Pin, 1);
	HAL_GPIO_WritePin(CLEAR_GPIO_Port, CLEAR_Pin, 1);

	RTC_TimeTypeDef sTimeStamp;
	RTC_DateTypeDef sTimeStampDate;

	sTimeStamp.Hours = 23;
	sTimeStamp.Minutes = 59;
	sTimeStamp.Seconds = 58;

	sTimeStamp.DayLightSaving = RTC_DAYLIGHTSAVING_NONE;
	sTimeStamp.StoreOperation = RTC_STOREOPERATION_SET;

	sTimeStamp.StoreOperation = RTC_STOREOPERATION_SET;
	HAL_StatusTypeDef result;

	result = HAL_RTC_SetTime(&hrtc, &sTimeStamp, RTC_FORMAT_BIN);
	if(result != HAL_OK){
		while(1);
	}

	seven_segment hour_ten;
	seven_segment hour_one;
	seven_segment minute_ten;
	seven_segment minute_one;
	seven_segment second_ten;
	seven_segment second_one;

	display_segment disp_hour;
	display_segment disp_minute;
	display_segment disp_second;

	hour_ten.a_port = A_HT_GPIO_Port;
	hour_ten.a_pin = A_HT_Pin;
	hour_ten.clock_port = CLK_A_HT_GPIO_Port;
	hour_ten.clock_pin = CLK_A_HT_Pin;
	hour_ten.enable_port = EN_HT_GPIO_Port;
	hour_ten.enable_pin = EN_HT_Pin;
	hour_ten.enable_segment = 1;

	hour_one.a_port = A_HO_GPIO_Port;
	hour_one.a_pin = A_HO_Pin;
	hour_one.clock_port = CLK_A_HO_GPIO_Port;
	hour_one.clock_pin = CLK_A_HO_Pin;
	hour_one.enable_port = EN_HO_GPIO_Port;
	hour_one.enable_pin = EN_HO_Pin;
	hour_one.enable_segment = 1;

	minute_ten.a_port = A_MT_GPIO_Port;
	minute_ten.a_pin = A_MT_Pin;
	minute_ten.clock_port = CLK_A_MT_GPIO_Port;
	minute_ten.clock_pin = CLK_A_MT_Pin;
	minute_ten.enable_port = EN_MT_GPIO_Port;
	minute_ten.enable_pin = EN_MT_Pin;
	minute_ten.enable_segment = 1;

	minute_one.a_port = A_MO_GPIO_Port;
	minute_one.a_pin = A_MO_Pin;
	minute_one.clock_port = CLK_A_MO_GPIO_Port;
	minute_one.clock_pin = CLK_A_MO_Pin;
	minute_one.enable_port = EN_MO_GPIO_Port;
	minute_one.enable_pin = EN_MO_Pin;
	minute_one.enable_segment = 1;

	second_ten.a_port = A_ST_GPIO_Port;
	second_ten.a_pin = A_ST_Pin;
	second_ten.clock_port = CLK_A_ST_GPIO_Port;
	second_ten.clock_pin = CLK_A_ST_Pin;
	second_ten.enable_port = EN_ST_GPIO_Port;
	second_ten.enable_pin = EN_ST_Pin;
	second_ten.enable_segment = 1;

	second_one.a_port = A_SO_GPIO_Port;
	second_one.a_pin = A_SO_Pin;
	second_one.clock_port = CLK_A_SO_GPIO_Port;
	second_one.clock_pin = CLK_A_SO_Pin;
	second_one.enable_port = EN_SO_GPIO_Port;
	second_one.enable_pin = EN_SO_Pin;
	second_one.enable_segment = 1;

	disp_hour.ten = &hour_ten;
	disp_hour.one = &hour_one;
	disp_hour.data = 00;
	disp_hour.data_old = 255;

	disp_minute.ten = &minute_ten;
	disp_minute.one = &minute_one;
	disp_minute.data = 00;
	disp_minute.data_old = 255;

	disp_second.ten = &second_ten;
	disp_second.one = &second_one;
	disp_second.data = 00;
	disp_second.data_old = 255;

	Button button_up = {
			BUTTON_IDLE,
			BUTTON_LONG_PRESS,
			0,
			0,
			0,
			BTN_UP_GPIO_Port,
			BTN_UP_Pin
	};

	Button button_down = {
			BUTTON_IDLE,
			BUTTON_LONG_PRESS,
			0,
			0,
			0,
			BTN_DOWN_GPIO_Port,
			BTN_DOWN_Pin
	};
	Button button_left = {
			BUTTON_IDLE,
			BUTTON_LONG_PRESS,
			0,
			0,
			0,
			BTN_LEFT_GPIO_Port,
			BTN_LEFT_Pin
	};
	Button button_right = {
			BUTTON_IDLE,
			BUTTON_LONG_PRESS,
			0,
			0,
			0,
			BTN_RIGHT_GPIO_Port,
			BTN_RIGHT_Pin
	};

	button_up.state_old = 0;
	button_down.state_old = 0;
	button_left.state_old = 0;

	DisplayState display_state = DISPLAY_INIT;
	PiTime pi_times;
	uint8_t dot = 0;

  /* USER CODE END 2 */

  /* Infinite loop */
  /* USER CODE BEGIN WHILE */
	while (1) {
    /* USER CODE END WHILE */

    /* USER CODE BEGIN 3 */
		process_button(&button_up);
		process_button(&button_down);
		process_button(&button_left);
		process_button(&button_right);

		if(button_up.state == BUTTON_PRESSED){
			if(button_up.state_old == 0){
				button_up.state_old = 1;
				if(display_state == DISPLAY_TIME){
					display_state = DISPLAY_DATE;
				}else{
					display_state = DISPLAY_TIME;
				}
			}
		}else if(button_up.state == BUTTON_RELEASED){
			button_up.state_old = 0;
		}

		if (button_down.state == BUTTON_LONG_PRESS) {
			if(button_down.state_old == 0){
				button_down.state_old = 1;
				send_uart_command("time");
				receive_uart_response(time_buffer, sizeof(time_buffer));
				parse_time_string(time_buffer, &pi_times);

				sTimeStamp.Hours = (uint8_t) pi_times.hours;
				sTimeStamp.Minutes = (uint8_t) pi_times.minutes;
				sTimeStamp.Seconds = (uint8_t) pi_times.seconds;

				sTimeStamp.DayLightSaving = RTC_DAYLIGHTSAVING_NONE;
				sTimeStamp.StoreOperation = RTC_STOREOPERATION_SET;

				sTimeStamp.StoreOperation = RTC_STOREOPERATION_SET;
				HAL_StatusTypeDef result;

				result = HAL_RTC_SetTime(&hrtc, &sTimeStamp, RTC_FORMAT_BIN);
				if(result != HAL_OK){
					while(1);
				}
			}
		}else if(button_down.state == BUTTON_RELEASED){
			button_down.state_old = 0;
		}

		if (button_left.state == BUTTON_LONG_PRESS) {
			if(button_left.state_old == 0){
				button_left.state_old = 1;
				send_uart_command("date");
				receive_uart_response(date_buffer, sizeof(date_buffer));
				parse_date_string(date_buffer, &pi_times);

				sTimeStampDate.Year = (uint8_t) (pi_times.years % 100);
				sTimeStampDate.Month = (uint8_t) pi_times.months;
				sTimeStampDate.Date = (uint8_t) pi_times.seconds;

				result = HAL_RTC_SetTime(&hrtc, &sTimeStamp, RTC_FORMAT_BIN);
				result = HAL_RTC_SetDate(&hrtc, &sTimeStampDate, RTC_FORMAT_BIN);
				if(result != HAL_OK){
					while(1);
				}
			}
		}else if(button_left.state == BUTTON_RELEASED){
			button_left.state_old = 0;
		}

		result = HAL_RTC_GetDate(&hrtc, &sTimeStampDate, RTC_FORMAT_BIN);
		result = HAL_RTC_GetTime(&hrtc, &sTimeStamp, RTC_FORMAT_BIN);


		switch(display_state){
		case DISPLAY_INIT:
			display_state = DISPLAY_TIME;
			break;
		case DISPLAY_TIME:
			disp_hour.data = sTimeStamp.Hours;
			disp_minute.data = sTimeStamp.Minutes;
			disp_second.data = sTimeStamp.Seconds;
			dot = 0;
			break;
		case DISPLAY_DATE:
			disp_hour.data = sTimeStampDate.Date;
			disp_minute.data = sTimeStampDate.Month;
			disp_second.data = sTimeStampDate.Year;
			dot = 1;
			break;
		case DISPLAY_TEMPERATURE:
			break;
		default:
			break;
		}

		display_write_segment(&disp_hour, dot);
		display_write_segment(&disp_minute, dot);
		display_write_segment(&disp_second, dot);

		HAL_Delay(10);
	}
  /* USER CODE END 3 */
}

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
