sinanuyan/pi_clock/firmware/Core/Inc/main.h

#define CLEAR_Pin GPIO_PIN_0
#define CLEAR_GPIO_Port GPIOA
#define A_HT_Pin GPIO_PIN_1
#define A_HT_GPIO_Port GPIOA
#define CLK_A_HT_Pin GPIO_PIN_2
#define CLK_A_HT_GPIO_Port GPIOA
#define EN_HT_Pin GPIO_PIN_3
#define EN_HT_GPIO_Port GPIOA
#define A_HO_Pin GPIO_PIN_4
#define A_HO_GPIO_Port GPIOA
#define CLK_A_HO_Pin GPIO_PIN_5
#define CLK_A_HO_GPIO_Port GPIOA
#define A_MT_Pin GPIO_PIN_6
#define A_MT_GPIO_Port GPIOA
#define CLK_A_MT_Pin GPIO_PIN_7
#define CLK_A_MT_GPIO_Port GPIOA
#define BTN_UP_Pin GPIO_PIN_0
#define BTN_UP_GPIO_Port GPIOB
#define BTN_UP_EXTI_IRQn EXTI0_1_IRQn
#define BTN_DOWN_Pin GPIO_PIN_1
#define BTN_DOWN_GPIO_Port GPIOB
#define BTN_DOWN_EXTI_IRQn EXTI0_1_IRQn
#define BTN_LEFT_Pin GPIO_PIN_2
#define BTN_LEFT_GPIO_Port GPIOB
#define BTN_LEFT_EXTI_IRQn EXTI2_3_IRQn
#define EN_MO_Pin GPIO_PIN_12
#define EN_MO_GPIO_Port GPIOB
#define EN_ST_Pin GPIO_PIN_13
#define EN_ST_GPIO_Port GPIOB
#define EN_SO_Pin GPIO_PIN_14
#define EN_SO_GPIO_Port GPIOB
#define A_MO_Pin GPIO_PIN_8
#define A_MO_GPIO_Port GPIOA
#define CLK_A_MO_Pin GPIO_PIN_9
#define CLK_A_MO_GPIO_Port GPIOA
#define A_ST_Pin GPIO_PIN_10
#define A_ST_GPIO_Port GPIOA
#define CLK_A_ST_Pin GPIO_PIN_11
#define CLK_A_ST_GPIO_Port GPIOA
#define A_SO_Pin GPIO_PIN_12
#define A_SO_GPIO_Port GPIOA
#define CLK_A_SO_Pin GPIO_PIN_15
#define CLK_A_SO_GPIO_Port GPIOA
#define BTN_RIGHT_Pin GPIO_PIN_3
#define BTN_RIGHT_GPIO_Port GPIOB
#define BTN_RIGHT_EXTI_IRQn EXTI2_3_IRQn
#define EN_HO_Pin GPIO_PIN_4
#define EN_HO_GPIO_Port GPIOB
#define EN_MT_Pin GPIO_PIN_5
#define EN_MT_GPIO_Port GPIOB
