sinanuyan/pi_clock/(commit log)

2024-09-24 add hw files
    [01 - Overview.SchDoc, 03 - MCU.SchDoc, 04 - Display.SchDoc, 05 - Connector.SchDoc, 0A - Blockschema.SchDoc, 98 - MECH.SchDoc, pi_clock.PrjPcb, pi_clock_1_A_1_BOM.xlsx]
2024-10-17 add documentation, add temperature sensor
    [costed_pi_clock_1_A_1_BOM.xlsx, segment.xlsx]
2024-10-17 change 7 segment circuit
    [01 - Overview.SchDoc, 03 - MCU.SchDoc, 04 - Display.SchDoc, 05 - Connector.SchDoc]
2024-12-08 add tp
    [03 - MCU.SchDoc, 05 - Connector.SchDoc]
2024-12-08 remove old output files
    [03 - MCU.SchDoc, pi_clock_1_A_1_BOM.xlsx, pi_clock_1_A_1_Pick Place.csv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]
2024-12-08 new output files
    [pi_clock.PrjPcb, pi_clock_2_B_1_BOM.xlsx, pi_clock_2_B_1_Pick Place.csv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]
2025-01-09 implement old data
    [enclosure_top-Extrude.stl, enclosure_top.FCStd]
2025-05-05 implement button press and rtc
2025-05-09 serial time and date output for raspberry pi
2025-05-09 date and time sync with raspberry pi over uart
